zeulewan/geodude-control/README.md

# GEO-DUDe Control

Hardware photo:

GEO-DUDe hardware photo

GUI demo:

GEO-DUDe GUI demo
