zeulewan/geodude-control/firmware/README.md

# Firmware

- `nucleo/`: STM32 Nucleo / SimpleFOC firmware
- `esp32/`: ESP32 gimbal firmware

Keep motor-control debug firmware documented here or in `CLAUDE.md` before flashing hardware.
