zeulewan/geodude-control/site/docs/project/index.md

# Project

Build status and procurement tracking.

<div class="grid cards" markdown>

-   :material-format-list-bulleted:{ .lg .middle } **Bill of Materials**

    ---

    Combined BOM for both systems with links to every component

    [:octicons-arrow-right-24: BOM](bom.md)

-   :material-truck-delivery:{ .lg .middle } **Procurement**

    ---

    Order status tracking

    [:octicons-arrow-right-24: Procurement](procurement.md)

</div>

---

## Key Links

| | |
|---|---|
| **Master BOM Spreadsheet** | [Google Sheets](https://docs.google.com/spreadsheets/d/1E1N-070xhcGK5FVkjd1sBZlGc8as569FgII3UE0jsTo/edit) |
| **PDR Report** | [Google Docs](https://docs.google.com/document/d/1te-EMC-su-nKf4tSHoRYxlYj9CKJehac/edit) |
| **Task 1 Requirements** | [Google Docs](https://docs.google.com/document/d/133SueeWXB8xnZ3yEcHK812wfZaEP6CewT1eUr0M1OwU/edit) |

---

## Open Items

- [ ] Get servo datasheets and fill in power budget
- [ ] Verify buck converter current ratings
- [ ] Verify slip ring wire count is sufficient
- [ ] Size all fuses
- [ ] Assign GPIO pin mapping for Pi and ESP32
