zeulewan/geodude-control/pcb/geodude-carrier/render.png

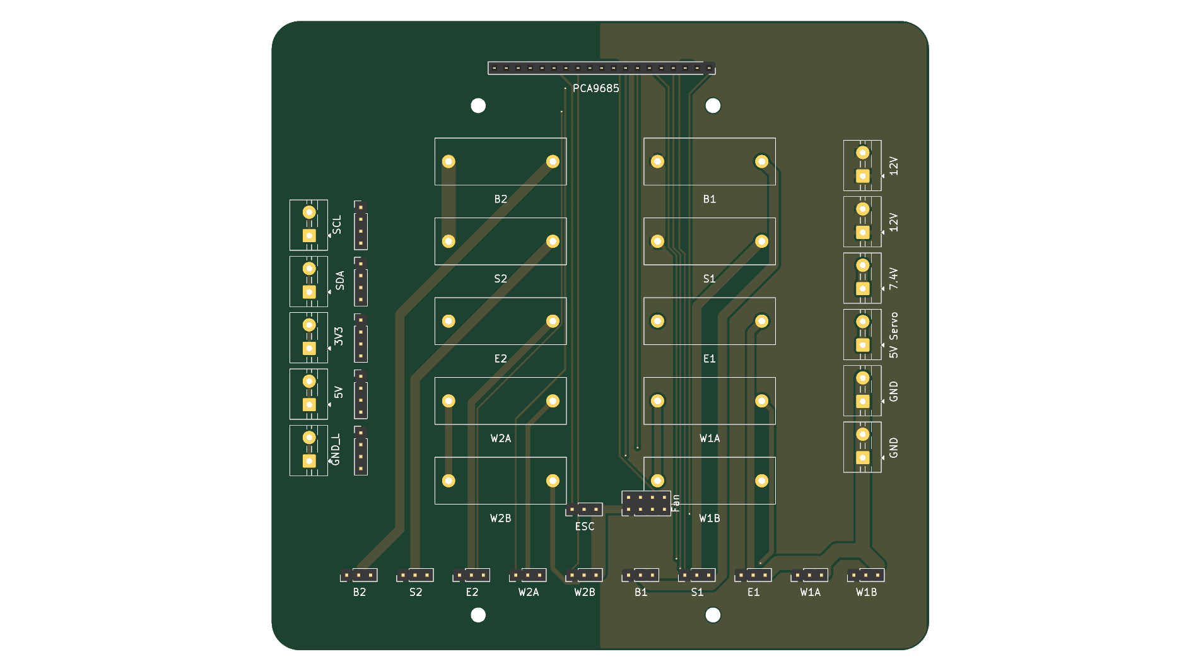
pcb/geodude-carrier/render.png
