zeulewan/geodude-control/site/docs/electrical/diagrams/L2-geodude-power-preview.png

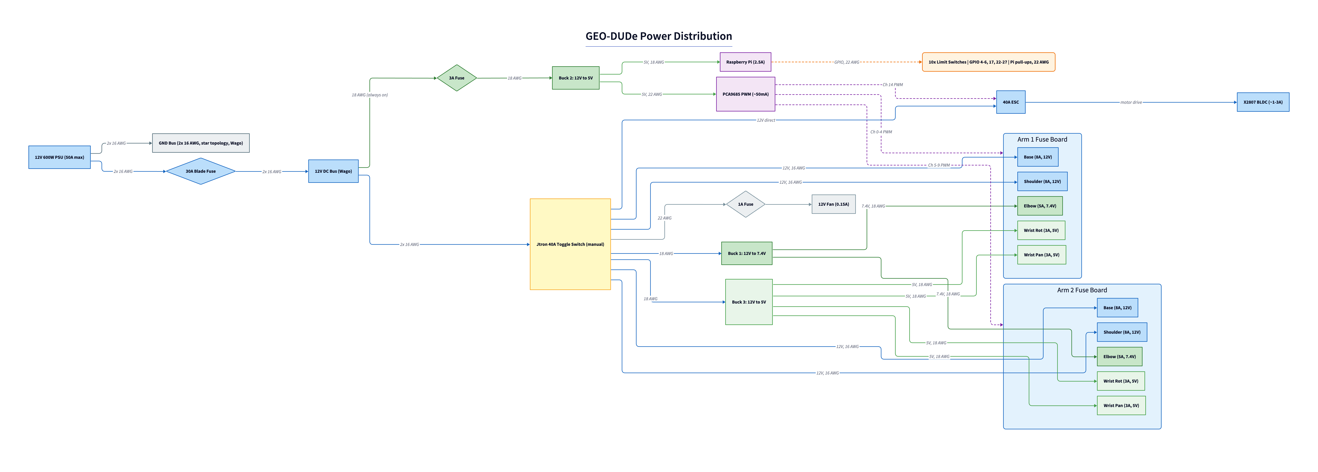
site/docs/electrical/diagrams/L2-geodude-power-preview.png
