zeulewan/geodude-control/(list of files, drawings)

Other design files:
pcb/geodude-carrier/geodude-carrier.dsn
