zeulewan/geodude-control/pcb/geodude-carrier/geodude-carrier.kicad_pcb

## KiCad design pcb/geodude-carrier/geodude-carrier.kicad_pcb (2026-03-31)

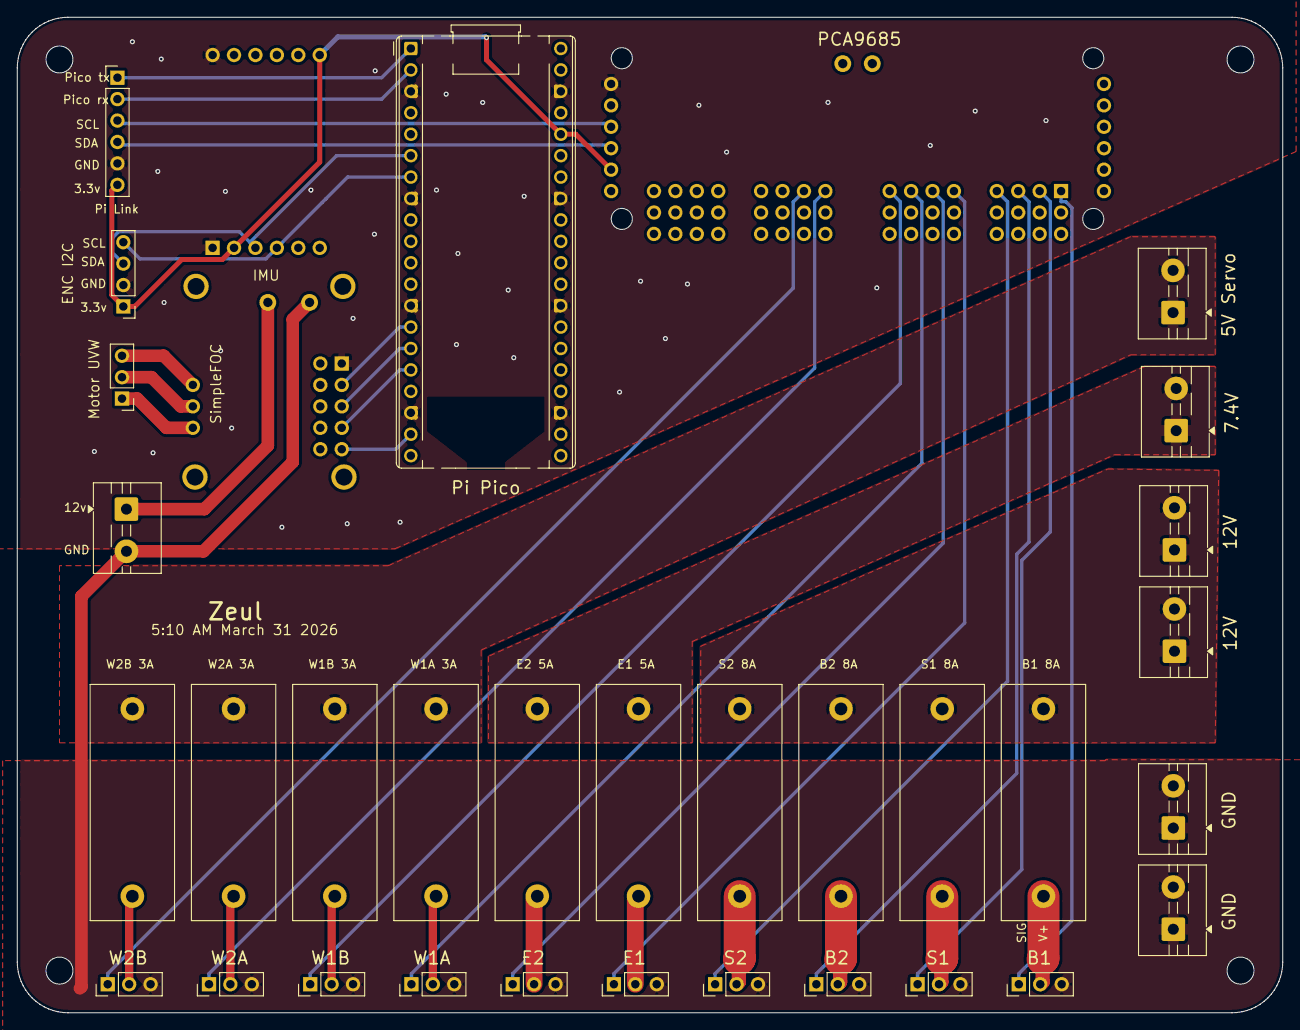
[picture p3: board geodude-carrier.kicad_pcb from above]

Board: 2 copper layers, 150.0 x 118.0 mm, 38 parts (1 on the bottom side), 40 nets.

Parts:
F1: B1 8A; BLX-A_5x20mm
F2: S1 8A; BLX-A_5x20mm
F3: E1 5A; BLX-A_5x20mm
F4: W1A 3A; BLX-A_5x20mm
F5: W1B 3A; BLX-A_5x20mm
F6: B2 8A; BLX-A_5x20mm
F7: S2 8A; BLX-A_5x20mm
F8: E2 5A; BLX-A_5x20mm
F9: W2A 3A; BLX-A_5x20mm
F10: W2B 3A; BLX-A_5x20mm
J1, J2: 12V; TerminalBlock_MaiXu_MX126-5.0-02P_1x02_P5.00mm
J3, J4: GND; TerminalBlock_MaiXu_MX126-5.0-02P_1x02_P5.00mm
J5: 7.4V; TerminalBlock_MaiXu_MX126-5.0-02P_1x02_P5.00mm
J6: 5V Servo; TerminalBlock_MaiXu_MX126-5.0-02P_1x02_P5.00mm
J_ENC: ENC I2C; PinHeader_1x04_P2.54mm_Vertical
J_FOC: SimpleFOC; SimpleFOC_Mini
J_FOC_12V: 12V FOC; TerminalBlock_MaiXu_MX126-5.0-02P_1x02_P5.00mm
J_IMU: IMU; SparkFun_ICM20948
J_MOTOR: Motor UVW; PinHeader_1x03_P2.54mm_Vertical
J_PCA: PCA9685; PCA9685_Breakout
J_PICO: Pi Pico; RaspberryPi_Pico_Common_THT
J_SERIAL: Pi Link; PinHeader_1x06_P2.54mm_Vertical
MH1, MH2, MH3, MH4: M3; MountingHole_3.2mm_M3
SV1: B1; PinHeader_1x03_P2.54mm_Vertical
SV2: S1; PinHeader_1x03_P2.54mm_Vertical
SV3: E1; PinHeader_1x03_P2.54mm_Vertical
SV4: W1A; PinHeader_1x03_P2.54mm_Vertical
SV5: W1B; PinHeader_1x03_P2.54mm_Vertical
SV6: B2; PinHeader_1x03_P2.54mm_Vertical
SV7: S2; PinHeader_1x03_P2.54mm_Vertical
SV8: E2; PinHeader_1x03_P2.54mm_Vertical
SV9: W2A; PinHeader_1x03_P2.54mm_Vertical
SV10: W2B; PinHeader_1x03_P2.54mm_Vertical

Connections:
+3V3: J_ENC.1, J_IMU.2, J_IMU.12, J_PCA.56, J_PICO.36, J_SERIAL.6
+5V_SERVO: F4.1, F5.1, F9.1, F10.1, J6.1, J6.2
+7V4: F3.1, F8.1, J5.1, J5.2
+12V: F1.1, F2.1, F6.1, F7.1, J1.1, J1.2, J2.1, J2.2
+12V_FOC: J_FOC.15, J_FOC_12V.1
FOC_EN: J_FOC.3, J_PICO.14
FOC_IN1: J_FOC.9, J_PICO.19
FOC_IN2: J_FOC.7, J_PICO.16
FOC_IN3: J_FOC.5, J_PICO.15
GND: J3.1, J3.2, J4.1, J4.2, J_FOC.14, J_FOC_12V.2, SV1.3, SV2.3, SV3.3, SV4.3, SV5.3, SV6.3, SV7.3, SV8.3, SV9.3, SV10.3
GND_LOGIC: J_ENC.2, J_FOC.1, J_IMU.1, J_IMU.7, J_PCA.60, J_PICO.3, J_PICO.8, J_PICO.13, J_PICO.18, J_PICO.23, J_PICO.28, J_PICO.33, J_PICO.38, J_SERIAL.5
MOTOR_U: J_FOC.11, J_MOTOR.3
MOTOR_V: J_FOC.12, J_MOTOR.2
MOTOR_W: J_FOC.13, J_MOTOR.1
PICO_RX: J_PICO.2, J_SERIAL.2
PICO_SCL: J_ENC.4, J_IMU.4, J_PICO.7
PICO_SDA: J_ENC.3, J_IMU.3, J_PICO.6
PICO_TX: J_PICO.1, J_SERIAL.1
PWM_CH0: J_PCA.1, SV1.1
PWM_CH1: J_PCA.4, SV2.1
PWM_CH2: J_PCA.7, SV6.1
PWM_CH3: J_PCA.10, SV7.1
PWM_CH4: J_PCA.13, SV3.1
PWM_CH5: J_PCA.16, SV8.1
PWM_CH6: J_PCA.19, SV4.1
PWM_CH7: J_PCA.22, SV5.1
PWM_CH8: J_PCA.25, SV9.1
PWM_CH9: J_PCA.28, SV10.1
SCL: J_PCA.58, J_SERIAL.3
SDA: J_PCA.57, J_SERIAL.4
SV1_PWR: F1.2, SV1.2
SV2_PWR: F2.2, SV2.2
SV3_PWR: F3.2, SV3.2
SV4_PWR: F4.2, SV4.2
SV5_PWR: F5.2, SV5.2
SV6_PWR: F6.2, SV6.2
SV7_PWR: F7.2, SV7.2
SV8_PWR: F8.2, SV8.2
SV9_PWR: F9.2, SV9.2
SV10_PWR: F10.2, SV10.2
