zeulewan/geodude-control/geodude/backend/sensor_server.py

from flask import Flask, jsonify, request, Response
import smbus2
import subprocess
import threading
import time
import os
import serial
import math
import json

app = Flask(__name__)
bus = smbus2.SMBus(1)
lock = threading.Lock()

# --- SimpleFOC serial (STM32 / Nucleo over USB) ---

PICO_PORT = "/dev/ttyACM0"
PICO_BAUD = 115200
pico_serial = None
pico_lock = threading.Lock()
simplefoc_status_lock = threading.Lock()
simplefoc_status_cache = {
    "connected": False,
    "status": None,
    "error": None,
    "updated_at": 0.0,
}


def _simplefoc_cache_status(status=None, error=None):
    with simplefoc_status_lock:
        simplefoc_status_cache["connected"] = bool(pico_serial is not None and pico_serial.is_open)
        if status is not None:
            simplefoc_status_cache["status"] = dict(status)
        if error is not None:
            simplefoc_status_cache["error"] = str(error)
        elif status is not None:
            simplefoc_status_cache["error"] = None
        simplefoc_status_cache["updated_at"] = time.monotonic()


def _simplefoc_status_snapshot():
    with simplefoc_status_lock:
        snap = dict(simplefoc_status_cache)
    status = snap.get("status") or {}
    return {
        "connected": bool(snap.get("connected")),
        "target": status.get("target", status.get("run_target")),
        "wheel_rpm": status.get("enc_rpm"),
        "wheel_angle_deg": status.get("enc_deg"),
        "foc_ready": status.get("foc_ready"),
        "armed": status.get("armed"),
        "raw_status": status if status else None,
        "serial_error": snap.get("error"),
        "updated_at": snap.get("updated_at", 0.0),
    }

def get_pico():
    """Return open serial port to the STM32 / Nucleo controller, opening it lazily if needed."""
    global pico_serial
    with pico_lock:
        if pico_serial is None or not pico_serial.is_open:
            try:
                pico_serial = serial.Serial(PICO_PORT, PICO_BAUD, timeout=0.5)
                _simplefoc_cache_status(status=None, error=None)
                # Firmware state unknown across a re-open: force re-push of
                # mode/voltage/ramp on next jog.
                simplefoc_pushed["mode"] = None
                simplefoc_pushed["voltage"] = None
                simplefoc_pushed["ramp"] = None
            except Exception as e:
                print("SimpleFOC serial open error: %s" % e, flush=True)
                pico_serial = None
                _simplefoc_cache_status(status=None, error=e)
        return pico_serial


def _simplefoc_fire_and_forget_locked(ser, cmd):
    """Write a command and return immediately, without draining replies.
    Used on the jog hot path (T, E, D) where firmware produces no output
    while armed and where we accept losing an ERR reply in exchange for
    latency. Any status line the firmware emits will be picked up by the
    next actual read (status poll, calibrate, etc.). Caller MUST hold
    pico_lock."""
    cmd = str(cmd).strip()
    if not cmd:
        return
    ser.write((cmd + "\n").encode())
    ser.flush()


def _simplefoc_exchange_locked(ser, cmd, read_for=0.2):
    cmd = str(cmd).strip()
    if not cmd:
        return [], None, None
    try:
        ser.reset_input_buffer()
    except Exception:
        pass
    ser.write((cmd + "\n").encode())
    ser.flush()
    lines = []
    last_status = None
    err = None
    end = time.time() + read_for
    while time.time() < end:
        line = ser.readline().decode(errors="ignore").strip()
        if not line:
            continue
        lines.append(line)
        if line.startswith("ERR"):
            err = line
            break
        if line.startswith("{") and line.endswith("}"):
            try:
                last_status = json.loads(line)
                _simplefoc_cache_status(status=last_status, error=None)
            except Exception as exc:
                err = "status parse error: %s" % exc
                _simplefoc_cache_status(error=err)
                break
    return lines, last_status, err


def _simplefoc_status_locked(ser, timeout=0.25):
    _lines, status, err = _simplefoc_exchange_locked(ser, "S", read_for=timeout)
    if err:
        raise RuntimeError(err)
    return status


def simplefoc_send(cmd, read_for=0.2):
    """Send a raw SimpleFOC Commander command and surface firmware ERR replies."""
    global pico_serial
    try:
        ser = get_pico()
        if ser is None:
            return False, "serial not available"
        with pico_lock:
            _lines, _status, err = _simplefoc_exchange_locked(ser, cmd, read_for=read_for)
        print("SimpleFOC: sent %r" % str(cmd).strip(), flush=True)
        if err:
            return False, err
        return True, None
    except Exception as e:
        with pico_lock:
            pico_serial = None
        _simplefoc_cache_status(error=e)
        print("SimpleFOC serial error: %s" % e, flush=True)
        return False, str(e)


SIMPLEFOC_JOG_MAX_RPM = 500.0
SIMPLEFOC_JOG_MAX_RAD_S = SIMPLEFOC_JOG_MAX_RPM * 2.0 * math.pi / 60.0
SIMPLEFOC_JOG_MIN_VOLTAGE = 0.5
SIMPLEFOC_JOG_MAX_VOLTAGE = 24.0
SIMPLEFOC_JOG_MIN_RAMP = 0.1
SIMPLEFOC_JOG_MAX_RAMP = 2000.0  # matches firmware R cap; ~30ms to target
SIMPLEFOC_JOG_TIMEOUT_S = 0.5

simplefoc_jog_lock = threading.Lock()
simplefoc_jog_state = {
    "active": None,  # forward/backward/brake
    "status": "idle",
    "error": None,
    "simplefoc_target": 0.0,
    "max_voltage": 12.0,
    "accel_ramp": 5.0,
    "brake_ramp": 12.0,
    "last_heartbeat": 0.0,
    "last_command_at": 0.0,
}

# Pre-empt counter: any /jog/stop bumps cmd_counter and stamps last_stop_seq.
# /jog/start captures its own seq; if last_stop_seq > my_seq before we emit
# T+E, we abort. Ensures a release that arrives mid-start cannot be overtaken
# by the start's final motor-enable.
simplefoc_cmd_counter = 0
simplefoc_last_stop_seq = 0

# Cached firmware config. Only push MR/V/R over serial when the request
# differs from what the firmware already has. Turns the hot path from a
# 6-command burst into 1-2 commands on repeat presses.
# Cleared on disconnect / boot so first press after reboot still pushes.
simplefoc_pushed = {"mode": None, "voltage": None, "ramp": None}


def _simplefoc_jog_clamp_voltage(value):
    return max(SIMPLEFOC_JOG_MIN_VOLTAGE, min(float(value), SIMPLEFOC_JOG_MAX_VOLTAGE))


def _simplefoc_jog_clamp_ramp(value):
    return max(SIMPLEFOC_JOG_MIN_RAMP, min(float(value), SIMPLEFOC_JOG_MAX_RAMP))


def _simplefoc_jog_snapshot():
    with simplefoc_jog_lock:
        snap = dict(simplefoc_jog_state)
    snap.update(_simplefoc_status_snapshot())
    snap["target"] = snap.get("simplefoc_target")
    return snap


def _rw_log(event, **fields):
    """Structured jog-path log. Grep with: journalctl -u sensor-server -f | grep '\\[rw\\]'
    Fields are key=value, space-separated, sorted by key for stable output."""
    parts = [f"{k}={fields[k]}" for k in sorted(fields)]
    print(f"[rw] {event} " + " ".join(parts), flush=True)


def _simplefoc_jog_disable(status="idle", error=None):
    """Coast via firmware `D` (disable drivers). This is the release/watchdog
    failsafe: coast, never active brake."""
    global simplefoc_last_stop_seq, simplefoc_cmd_counter, pico_serial
    t0 = time.monotonic()
    with simplefoc_jog_lock:
        simplefoc_cmd_counter += 1
        simplefoc_last_stop_seq = simplefoc_cmd_counter
        prev_active = simplefoc_jog_state["active"]
    # Fire-and-forget D. Release must be snappy; firmware emits nothing we
    # need to read synchronously.
    try:
        ser = get_pico()
        if ser is not None:
            with pico_lock:
                _simplefoc_fire_and_forget_locked(ser, "D")
    except Exception as e:
        with pico_lock:
            pico_serial = None
        _simplefoc_cache_status(error=e)
    with simplefoc_jog_lock:
        simplefoc_jog_state["active"] = None
        simplefoc_jog_state["status"] = status
        simplefoc_jog_state["error"] = error
        simplefoc_jog_state["simplefoc_target"] = 0.0
        simplefoc_jog_state["last_command_at"] = time.monotonic()
    _rw_log("coast", reason=status, prev=prev_active, err=error,
            stop_seq=simplefoc_last_stop_seq, elapsed_ms=round((time.monotonic()-t0)*1000, 1))


def _simplefoc_jog_start(direction, max_voltage, accel_ramp, brake_ramp):
    global simplefoc_cmd_counter
    t0 = time.monotonic()
    target = 0.0
    if direction == "forward":
        target = SIMPLEFOC_JOG_MAX_RAD_S
    elif direction == "backward":
        target = -SIMPLEFOC_JOG_MAX_RAD_S
    elif direction == "brake":
        target = 0.0
    else:
        raise ValueError("direction must be forward/backward/brake")
    ramp = brake_ramp if direction == "brake" else accel_ramp
    max_voltage = _simplefoc_jog_clamp_voltage(max_voltage)
    accel_ramp = _simplefoc_jog_clamp_ramp(accel_ramp)
    brake_ramp = _simplefoc_jog_clamp_ramp(brake_ramp)

    # Use cached foc_ready instead of a pre-flight serial round-trip. If the
    # cache is stale the firmware will reject `E` with ERR anyway.
    cached = _simplefoc_status_snapshot()
    if not cached.get("foc_ready"):
        raise RuntimeError("wheel not calibrated; run calibration first")

    with simplefoc_jog_lock:
        simplefoc_cmd_counter += 1
        my_seq = simplefoc_cmd_counter

    ser = get_pico()
    if ser is None:
        raise RuntimeError("serial not available")

    with pico_lock:
        # Lazy config push. Only send MR/V/R when the firmware doesn't already
        # have these values.
        pending = []
        if simplefoc_pushed["mode"] != "rate":
            pending.append(("MR", 0.03))
        vstr = f"{max_voltage:.3f}"
        if simplefoc_pushed["voltage"] != vstr:
            pending.append((f"V{vstr}", 0.03))
        rstr = f"{ramp:.3f}"
        if simplefoc_pushed["ramp"] != rstr:
            pending.append((f"R{rstr}", 0.03))

        for cmd, _delay in pending:
            _simplefoc_fire_and_forget_locked(ser, cmd)
        if pending:
            simplefoc_pushed["mode"] = "rate"
            simplefoc_pushed["voltage"] = vstr
            simplefoc_pushed["ramp"] = rstr

        # Pre-empt check: if a /jog/stop arrived after we took my_seq, abort.
        # The release has already (or will) coast via D; don't re-arm.
        with simplefoc_jog_lock:
            preempted = simplefoc_last_stop_seq > my_seq
        if preempted:
            # Belt-and-suspenders: ensure coast even if the release's D
            # somehow landed before our lock acquire.
            _simplefoc_exchange_locked(ser, "D", read_for=0.02)
            _rw_log("preempt", phase="pre_TE", direction=direction, my_seq=my_seq,
                    stop_seq=simplefoc_last_stop_seq,
                    elapsed_ms=round((time.monotonic()-t0)*1000, 1))
            raise RuntimeError("preempted by release")

        # Hot path: T then E. Fire-and-forget — firmware produces no reply
        # while armed, and we want pico_lock held for milliseconds not tens
        # of ms. If the firmware rejects (unlikely since we checked
        # foc_ready), the next status poll will show armed=false and the
        # user can retry. Watchdog still owns the safety net.
        _simplefoc_fire_and_forget_locked(ser, f"T{target:.5f}")
        _simplefoc_fire_and_forget_locked(ser, "E")

    with simplefoc_jog_lock:
        # Only claim active if no newer stop arrived during T+E.
        if simplefoc_last_stop_seq > my_seq:
            # A release snuck in; disable after unlocking.
            needs_coast = True
        else:
            needs_coast = False
            simplefoc_jog_state["active"] = direction
            simplefoc_jog_state["status"] = "running"
            simplefoc_jog_state["error"] = None
            simplefoc_jog_state["simplefoc_target"] = target
            simplefoc_jog_state["max_voltage"] = max_voltage
            simplefoc_jog_state["accel_ramp"] = accel_ramp
            simplefoc_jog_state["brake_ramp"] = brake_ramp
            simplefoc_jog_state["last_heartbeat"] = time.monotonic()
            simplefoc_jog_state["last_command_at"] = time.monotonic()
    if needs_coast:
        simplefoc_send("D")
        _rw_log("preempt", phase="post_TE", direction=direction, my_seq=my_seq,
                stop_seq=simplefoc_last_stop_seq,
                elapsed_ms=round((time.monotonic()-t0)*1000, 1))
        raise RuntimeError("preempted by release")
    _rw_log("hold_start", direction=direction, target=round(target, 3),
            v=max_voltage, ramp=round(ramp, 3),
            pushed=len(pending),
            my_seq=my_seq,
            elapsed_ms=round((time.monotonic()-t0)*1000, 1))


def simplefoc_status_poll_loop():
    """Refresh the status cache from the firmware so wheel_rpm stays live
    while the motor is spinning. Firmware only prints on events, so without
    this the UI reads a frozen value between press and release.

    Cadence is 500ms while active (3.4% of firmware time blocked on
    Serial.print — acceptable; tighten if needed) and 2s while idle (so
    /simplefoc/jog/status still shows a recent foc_ready etc.). Uses
    pico_lock with a short read_for so it loses the race to any user
    command cleanly."""
    while True:
        with simplefoc_jog_lock:
            active = simplefoc_jog_state["active"]
        period = 0.5 if active else 2.0
        try:
            ser = get_pico()
            if ser is not None:
                with pico_lock:
                    _simplefoc_status_locked(ser, timeout=0.05)
        except Exception as exc:
            _simplefoc_cache_status(error=exc)
        time.sleep(period)


def simplefoc_jog_watchdog_loop():
    while True:
        time.sleep(0.05)
        with simplefoc_jog_lock:
            active = simplefoc_jog_state["active"]
            last_heartbeat = simplefoc_jog_state["last_heartbeat"]
        if not active:
            continue
        stale_ms = round((time.monotonic() - last_heartbeat) * 1000, 0)
        if stale_ms <= SIMPLEFOC_JOG_TIMEOUT_S * 1000:
            continue
        _rw_log("watchdog_trip", active=active, stale_ms=stale_ms)
        try:
            _simplefoc_jog_disable(status="watchdog stop", error=None)
        except Exception as exc:
            with simplefoc_jog_lock:
                simplefoc_jog_state["active"] = None
                simplefoc_jog_state["status"] = "watchdog error"
                simplefoc_jog_state["error"] = str(exc)
                simplefoc_jog_state["last_command_at"] = time.monotonic()
            _rw_log("watchdog_err", err=str(exc))

sensor_data = {
    "ax": 0, "ay": 0, "az": 0,
    "gx": 0, "gy": 0, "gz": 0,
    "angle": 0, "rpm": 0,
    "analog_va": 0, "analog_vb": 0,
    "analog_electrical_deg": 0, "analog_mechanical_deg": 0,
    "i2c_ok": False, "ads_ok": False, "imu_ok": False,
}

# --- PCA9685 PWM driver ---

PCA9685_ADDR = 0x40
MODE1 = 0x00
PRESCALE = 0xFE
LED0_ON_L = 0x06

# Channel mapping (pin - 1 = 0-indexed)
# MACE reaction wheel is no longer on PCA9685 — it is driven by the STM32 / Nucleo SimpleFOC controller
CHANNELS = {
    "B1":   0,
    "S1":   1,
    "B2":   2,
    "S2":   3,
    "E1":   4,
    "E2":   5,
    "W1A":  6,
    "W1B":  7,
    "W2A":  8,
    "W2B":  9,
}

# --- Servo safety state ---
# Max change in pulse-width allowed per single /pwm request.
# Prevents servo jumps if the client-side ramp loses packets. Tune carefully:
#   - Too small: legitimate moves get clamped and feel laggy.
#   - Too large: big jumps can slip past.
# With client ramp at 30 Hz and max 10 us/tick, normal delta is <= 10 us.
# 50 us is a safe cap: legitimate ramp fits, jumps from lost commands get clipped.
SERVO_MAX_DELTA_US = 50

_servo_last_pw = {name: None for name in CHANNELS}  # last successfully written
_servo_last_seq = {name: -1 for name in CHANNELS}   # highest seq accepted
_servo_locks = {name: threading.Lock() for name in CHANNELS}
_servo_health_lock = threading.Lock()  # H-D/M-E: covers PCA counters + snapshot reads


def pca_init(freq=50):
    # Sleep to change prescale
    bus.write_byte_data(PCA9685_ADDR, MODE1, 0x10)  # SLEEP
    prescale = round(25_000_000 / (4096 * freq)) - 1
    bus.write_byte_data(PCA9685_ADDR, PRESCALE, prescale)
    # Wake: clear SLEEP, enable auto-increment + RESTART
    bus.write_byte_data(PCA9685_ADDR, MODE1, 0x00)  # wake
    time.sleep(0.005)
    bus.write_byte_data(PCA9685_ADDR, MODE1, 0xA0)  # RESTART + AI

_pca_write_errors = 0         # H-D: protected by _servo_health_lock
_pca_readback_mismatches = 0

def _pca_bump(counter_name):
    """H-D: atomic counter increment. CPython += on int is NOT atomic."""
    global _pca_write_errors, _pca_readback_mismatches
    with _servo_health_lock:
        if counter_name == "write":
            _pca_write_errors += 1
        else:
            _pca_readback_mismatches += 1


def pca_set_pulse_us(channel, pulse_us, freq=50):
    """Write + verify. Returns True on verified write, False on failure."""
    period_us = 1_000_000 / freq
    counts = int(pulse_us / period_us * 4096)
    counts = max(0, min(4095, counts))
    reg = LED0_ON_L + 4 * channel
    payload = [0, 0, counts & 0xFF, (counts >> 8) & 0xFF]
    for attempt in range(2):
        try:
            with lock:
                # H-E: reassert MODE1 = RESTART+AI so multi-byte readback
                # auto-increments. If the chip browned out and lost this bit,
                # readback would return the same register byte 4x and a
                # pw=0 write would falsely pass verification.
                bus.write_byte_data(PCA9685_ADDR, MODE1, 0xA0)
                bus.write_i2c_block_data(PCA9685_ADDR, reg, payload)
                got = bus.read_i2c_block_data(PCA9685_ADDR, reg, 4)
            if list(got) == payload:
                return True
            _pca_bump("mismatch")
        except Exception:
            _pca_bump("write")
    return False

def pca_off(channel):
    reg = LED0_ON_L + 4 * channel
    with lock:
        bus.write_i2c_block_data(PCA9685_ADDR, reg, [0, 0, 0, 0])

def pca_all_off():
    with lock:
        for ch in range(16):
            reg = LED0_ON_L + 4 * ch
            bus.write_i2c_block_data(PCA9685_ADDR, reg, [0, 0, 0, 0])

def _servo_seed_last_pw_from_pca(freq=50):
    """L-E: on boot, seed _servo_last_pw from whatever the PCA9685 is actually
    outputting right now. This closes the "first write bypasses clamp" hole
    where _servo_last_pw[name] was None so the 50us delta clamp was skipped.

    Must be called after pca_init so MODE1 auto-increment is on.
    """
    period_us = 1_000_000 / freq
    for name, ch in CHANNELS.items():
        reg = LED0_ON_L + 4 * ch
        try:
            with lock:
                got = bus.read_i2c_block_data(PCA9685_ADDR, reg, 4)
            counts = ((got[3] & 0x0F) << 8) | got[2]
            pw = int(round(counts * period_us / 4096))
            _servo_last_pw[name] = pw if 0 <= pw <= 2500 else 0
        except Exception:
            # Leave as None; first write will have no clamp — but log.
            print(f"[servo] seed_last_pw failed for {name}", flush=True)


# --- Sensor reading ---

ADS1115_ADDR = 0x48
MAGNET_COUNT = 32
ANALOG_POLE_PAIRS = MAGNET_COUNT // 2
SENSOR_SUPPLY_V = 3.3
OFFSET_A_V = SENSOR_SUPPLY_V * 0.5
OFFSET_B_V = SENSOR_SUPPLY_V * 0.5
AMP_ALPHA = 0.01
MIN_SIGNAL_V = 0.02
ANGLE_HOLD_THRESHOLD_V = 0.01


def _i16(msb, lsb):
    value = (msb << 8) | lsb
    return value - 0x10000 if value & 0x8000 else value


def _wrap_delta_deg(delta):
    while delta > 180.0:
        delta -= 360.0
    while delta < -180.0:
        delta += 360.0
    return delta


class ADS1115:
    REG_CONVERSION = 0x00
    REG_CONFIG = 0x01
    OS_SINGLE = 0x8000
    MUX_SINGLE = (0x4000, 0x5000, 0x6000, 0x7000)
    PGA_4V096 = 0x0200
    MODE_SINGLE = 0x0100
    DATA_RATE_860 = 0x00E0
    COMP_DISABLE = 0x0003

    def __init__(self, bus_obj, address=ADS1115_ADDR):
        self.bus = bus_obj
        self.address = address

    def read_raw(self, channel):
        config = (
            self.OS_SINGLE
            | self.MUX_SINGLE[channel]
            | self.PGA_4V096
            | self.MODE_SINGLE
            | self.DATA_RATE_860
            | self.COMP_DISABLE
        )
        self.bus.write_i2c_block_data(self.address, self.REG_CONFIG, [(config >> 8) & 0xFF, config & 0xFF])
        time.sleep(0.002)
        msb, lsb = self.bus.read_i2c_block_data(self.address, self.REG_CONVERSION, 2)
        return _i16(msb, lsb)

    def read_voltage(self, channel):
        return self.read_raw(channel) * (4.096 / 32768.0)


def r16(addr, reg):
    h = bus.read_byte_data(addr, reg)
    l = bus.read_byte_data(addr, reg + 1)
    v = (h << 8) | l
    return v - 65536 if v > 32767 else v

def sensor_loop():
    ads = ADS1115(bus, ADS1115_ADDR)
    imu_ready = False
    imu_warned = False
    last_imu_error = None
    offset_a = OFFSET_A_V
    offset_b = OFFSET_B_V
    amp_a = 1.0
    amp_b = 1.0
    prev_electrical_deg = None
    continuous_electrical_deg = 0.0
    last_mechanical_deg = None
    last_time = None
    rpm_buf = []
    while True:
        try:
            if not imu_ready:
                try:
                    with lock:
                        bus.write_byte_data(0x69, 0x06, 0x01)
                    time.sleep(0.05)
                    imu_ready = True
                    imu_warned = False
                    last_imu_error = None
                except Exception as e:
                    imu_ready = False
                    last_imu_error = e
                    if not imu_warned:
                        print("sensor_loop IMU unavailable; continuing without IMU: %s" % e, flush=True)
                        imu_warned = True
            with lock:
                va = ads.read_voltage(0)
                vb = ads.read_voltage(1)
            ax = ay = az = gx = gy = gz = 0.0
            imu_ok = False
            if imu_ready:
                try:
                    with lock:
                        ax = r16(0x69, 0x2D) / 16384.0
                        ay = r16(0x69, 0x2F) / 16384.0
                        az = r16(0x69, 0x31) / 16384.0
                        gx = r16(0x69, 0x33) / 131.0
                        gy = r16(0x69, 0x35) / 131.0
                        gz = r16(0x69, 0x37) / 131.0
                    imu_ok = True
                except Exception as e:
                    imu_ready = False
                    last_imu_error = e
                    print("sensor_loop IMU read failed; retrying init: %s" % e, flush=True)
            centered_a = va - offset_a
            centered_b = vb - offset_b
            amp_a = max(MIN_SIGNAL_V, (1.0 - AMP_ALPHA) * amp_a + AMP_ALPHA * abs(centered_a))
            amp_b = max(MIN_SIGNAL_V, (1.0 - AMP_ALPHA) * amp_b + AMP_ALPHA * abs(centered_b))
            norm_a = centered_a / amp_a
            norm_b = centered_b / amp_b

            electrical_deg = math.degrees(math.atan2(norm_b, norm_a))
            if electrical_deg < 0.0:
                electrical_deg += 360.0

            magnitude_v = math.sqrt(centered_a * centered_a + centered_b * centered_b)
            if magnitude_v >= ANGLE_HOLD_THRESHOLD_V:
                if prev_electrical_deg is None:
                    continuous_electrical_deg = electrical_deg
                else:
                    continuous_electrical_deg += _wrap_delta_deg(electrical_deg - prev_electrical_deg)
                prev_electrical_deg = electrical_deg
            elif prev_electrical_deg is None:
                prev_electrical_deg = electrical_deg

            continuous_mechanical_deg = continuous_electrical_deg / ANALOG_POLE_PAIRS
            angle = continuous_mechanical_deg % 360.0
            # Compute RPM from encoder at 100Hz
            now = time.monotonic()
            rpm = 0.0
            if last_mechanical_deg is not None and last_time is not None:
                dt = now - last_time
                if dt > 0:
                    delta = continuous_mechanical_deg - last_mechanical_deg
                    dps = delta / dt
                    rpm_buf.append(dps / 6.0)  # signed RPM
                    if len(rpm_buf) > 10:
                        rpm_buf.pop(0)
                    rpm = sum(rpm_buf) / len(rpm_buf)
            last_mechanical_deg = continuous_mechanical_deg
            last_time = now
            sensor_data.update({
                "ax": round(ax, 3), "ay": round(ay, 3), "az": round(az, 3),
                "gx": round(gx, 1), "gy": round(gy, 1), "gz": round(gz, 1),
                "angle": round(angle, 1),
                "rpm": round(rpm, 1),
                "analog_va": round(va, 5),
                "analog_vb": round(vb, 5),
                "analog_electrical_deg": round(electrical_deg, 2),
                "analog_mechanical_deg": round(angle, 2),
                "i2c_ok": True,
                "ads_ok": True,
                "imu_ok": imu_ok,
            })
        except Exception as e:
            print("sensor_loop error: %s" % e, flush=True)
            sensor_data.update({
                "i2c_ok": False,
                "ads_ok": False,
                "imu_ok": imu_ready and last_imu_error is None,
            })
        time.sleep(0.033)

# --- API ---

@app.route("/sensors")
def sensors():
    if os.path.exists("/tmp/motor_heartbeat"):
        os.utime("/tmp/motor_heartbeat", None)
    else:
        open("/tmp/motor_heartbeat","w").close()
    with lock:
        return jsonify(sensor_data)

@app.route("/system")
def system_stats():
    """CPU usage and temperature."""
    try:
        with open("/sys/class/thermal/thermal_zone0/temp") as f:
            temp = int(f.read().strip()) / 1000.0
    except Exception:
        temp = 0
    try:
        with open("/proc/loadavg") as f:
            load = float(f.read().split()[0])
    except Exception:
        load = 0
    try:
        with open("/proc/stat") as f:
            line = f.readline()
            parts = line.split()
            idle = int(parts[4])
            total = sum(int(x) for x in parts[1:])
        if not hasattr(system_stats, "_prev"):
            system_stats._prev = (total, idle)
        prev_total, prev_idle = system_stats._prev
        dt = total - prev_total
        di = idle - prev_idle
        cpu_pct = round((1.0 - di / dt) * 100, 1) if dt > 0 else 0
        system_stats._prev = (total, idle)
    except Exception:
        cpu_pct = 0
    return jsonify({"temp": round(temp, 1), "cpu": cpu_pct, "load": round(load, 2)})

@app.route("/simplefoc", methods=["POST"])
def simplefoc():
    """Send a velocity command to the wheel controller (SimpleFOC Commander protocol).
    Body: {"velocity": 5.0}  — sets target velocity in rad/s
       or {"command": "T5"} — sends a raw commander command
    """
    if os.path.exists("/tmp/attitude_active"):
        return jsonify({"ok": False, "error": "attitude controller active"}), 409
    data = request.json
    if "command" in data:
        cmd = str(data["command"])
    elif "velocity" in data:
        v = float(data["velocity"])
        cmd = "T%.4f" % v
    else:
        return jsonify({"ok": False, "error": "missing velocity or command"}), 400
    ok, err = simplefoc_send(cmd)
    if ok:
        return jsonify({"ok": True, "cmd": cmd})
    return jsonify({"ok": False, "error": err}), 502

@app.route("/simplefoc/status")
def simplefoc_status():
    """Query STM32 connection/target without fighting active serial traffic."""
    ser = get_pico()
    connected = ser is not None and ser.is_open
    cached = _simplefoc_status_snapshot()
    if simplefoc_jog_state.get("active"):
        return jsonify({
            "connected": connected,
            "target": simplefoc_jog_state.get("simplefoc_target"),
            "live": False,
            "jog": True,
            "foc_ready": cached.get("foc_ready"),
        })
    target = None
    if simplefoc_live_state.get("enabled") or simplefoc_live_state.get("sweep_busy"):
        return jsonify({
            "connected": connected,
            "target": simplefoc_live_state.get("rate_target_rpm"),
            "live": True,
        })
    if connected:
        try:
            with pico_lock:
                status = _simplefoc_status_locked(ser, timeout=0.25)
            if status:
                target = status.get("target", status.get("run_target"))
        except Exception as e:
            print("SimpleFOC status read error: %s" % e, flush=True)
            _simplefoc_cache_status(error=e)
    return jsonify({
        "connected": connected,
        "target": target,
        "foc_ready": cached.get("foc_ready"),
        "armed": cached.get("armed"),
        "serial_error": cached.get("serial_error"),
    })


@app.route("/simplefoc/jog/status")
def simplefoc_jog_status():
    return jsonify(_simplefoc_jog_snapshot())


@app.route("/simplefoc/jog/start", methods=["POST"])
def simplefoc_jog_start_route():
    with simplefoc_calibrate_lock:
        if simplefoc_calibrate_state["busy"]:
            return jsonify({"ok": False, "error": "calibrating"}), 409
    with simplefoc_profile_lock:
        if simplefoc_profile_state["busy"] or simplefoc_torque_state["busy"]:
            return jsonify({"ok": False, "error": "profile/torque busy"}), 409
    with simplefoc_live_lock:
        if simplefoc_live_state.get("enabled") or simplefoc_live_state.get("sweep_busy"):
            return jsonify({"ok": False, "error": "live control busy"}), 409
    data = request.json or {}
    direction = str(data.get("direction", "")).lower()
    if direction not in ("forward", "backward", "brake"):
        return jsonify({"ok": False, "error": "direction must be forward/backward/brake"}), 400
    max_voltage = _simplefoc_jog_clamp_voltage(data.get("max_voltage", 12.0))
    accel_ramp = _simplefoc_jog_clamp_ramp(data.get("accel_ramp", 5.0))
    brake_ramp = _simplefoc_jog_clamp_ramp(data.get("brake_ramp", 12.0))
    try:
        _simplefoc_jog_start(direction, max_voltage, accel_ramp, brake_ramp)
    except Exception as exc:
        with simplefoc_jog_lock:
            simplefoc_jog_state["status"] = "error"
            simplefoc_jog_state["error"] = str(exc)
            simplefoc_jog_state["last_command_at"] = time.monotonic()
        return jsonify({"ok": False, "error": str(exc)}), 502
    return jsonify({"ok": True, **_simplefoc_jog_snapshot()})


simplefoc_calibrate_lock = threading.Lock()
simplefoc_calibrate_state = {
    "busy": False,
    "status": "idle",
    "error": None,
}


def _simplefoc_calibrate_worker():
    """Send G to the firmware and wait for initFOC_ok / initFOC_failed.

    Decoupled from the tuning/profile subsystem so calibration and jog state
    don't cross-contaminate. Total wall time up to ~10s on a slow calibration.
    """
    t0 = time.monotonic()
    _rw_log("calibrate_start")
    ser = get_pico()
    if ser is None:
        with simplefoc_calibrate_lock:
            simplefoc_calibrate_state["busy"] = False
            simplefoc_calibrate_state["status"] = "error"
            simplefoc_calibrate_state["error"] = "serial not available"
        return
    try:
        with pico_lock:
            try:
                ser.reset_input_buffer()
            except Exception:
                pass
            ser.write(b"G\n")
            ser.flush()
            status = "running"
            err = None
            deadline = time.time() + 10.0
            while time.time() < deadline:
                line = ser.readline().decode(errors="ignore").strip()
                if not line:
                    continue
                if line.startswith("ERR"):
                    err = line
                    status = "error"
                    break
                if line.startswith("{") and line.endswith("}"):
                    try:
                        data = json.loads(line)
                        _simplefoc_cache_status(status=data, error=None)
                        event = data.get("event", "")
                        if event == "initFOC_ok" or data.get("foc_ready"):
                            status = "ready"
                            break
                        if event == "initFOC_failed":
                            status = "failed"
                            err = "initFOC_failed"
                            break
                    except Exception:
                        pass
        with simplefoc_calibrate_lock:
            simplefoc_calibrate_state["busy"] = False
            simplefoc_calibrate_state["status"] = status
            simplefoc_calibrate_state["error"] = err
        _rw_log("calibrate_done", status=status, err=err,
                elapsed_ms=round((time.monotonic()-t0)*1000, 0))
    except Exception as exc:
        with simplefoc_calibrate_lock:
            simplefoc_calibrate_state["busy"] = False
            simplefoc_calibrate_state["status"] = "error"
            simplefoc_calibrate_state["error"] = str(exc)
        _rw_log("calibrate_done", status="error", err=str(exc),
                elapsed_ms=round((time.monotonic()-t0)*1000, 0))


@app.route("/simplefoc/calibrate", methods=["POST"])
def simplefoc_calibrate_route():
    with simplefoc_calibrate_lock:
        if simplefoc_calibrate_state["busy"]:
            return jsonify({"ok": False, "error": "calibrating"}), 409
        simplefoc_calibrate_state["busy"] = True
        simplefoc_calibrate_state["status"] = "running"
        simplefoc_calibrate_state["error"] = None
    # A calibration invalidates cached pushed config (firmware disables motor
    # and resets limits inside run_calibration()).
    simplefoc_pushed["mode"] = None
    simplefoc_pushed["voltage"] = None
    simplefoc_pushed["ramp"] = None
    threading.Thread(target=_simplefoc_calibrate_worker, daemon=True).start()
    return jsonify({"ok": True})


@app.route("/simplefoc/calibrate/state")
def simplefoc_calibrate_state_route():
    with simplefoc_calibrate_lock:
        return jsonify(dict(simplefoc_calibrate_state))


@app.route("/simplefoc/jog/heartbeat", methods=["POST"])
def simplefoc_jog_heartbeat_route():
    """Heartbeat MUST NOT touch the serial port. It runs at 10Hz; a serial
    round-trip here starves the stop path of pico_lock. Fresh telemetry is
    the status poll's job."""
    data = request.json or {}
    direction = str(data.get("direction", "")).lower()
    with simplefoc_jog_lock:
        active = simplefoc_jog_state["active"]
        if direction and active and direction != active:
            return jsonify({"ok": False, "error": "active direction mismatch"}), 409
        if not active:
            return jsonify({"ok": False, "error": "no active hold"}), 409
        simplefoc_jog_state["last_heartbeat"] = time.monotonic()
    return jsonify({"ok": True, **_simplefoc_jog_snapshot()})


@app.route("/simplefoc/jog/stop", methods=["POST"])
def simplefoc_jog_stop_route():
    try:
        _simplefoc_jog_disable()
        error = None
    except Exception as exc:
        error = str(exc)
    with simplefoc_jog_lock:
        simplefoc_jog_state["last_command_at"] = time.monotonic()
    if error is not None:
        with simplefoc_jog_lock:
            simplefoc_jog_state["status"] = "error"
            simplefoc_jog_state["error"] = error
        return jsonify({"ok": False, "error": error}), 502
    return jsonify({"ok": True, **_simplefoc_jog_snapshot()})


# --- SimpleFOC autonomous profile tuning/logging ---

simplefoc_profile_lock = threading.Lock()
simplefoc_profile_stop_requested = False
simplefoc_profile_state = {
    "status": "idle",
    "busy": False,
    "last_status": None,
    "last_log": [],
    "raw": [],
    "error": None,
}


def _profile_add_raw(line):
    with simplefoc_profile_lock:
        simplefoc_profile_state["raw"].append(str(line))
        simplefoc_profile_state["raw"] = simplefoc_profile_state["raw"][-500:]


def _profile_set(**kwargs):
    with simplefoc_profile_lock:
        simplefoc_profile_state.update(kwargs)


def _profile_parse_status(line):
    if not line.startswith("{"):
        return None
    try:
        obj = json.loads(line)
    except Exception:
        return None
    _profile_set(last_status=obj)
    return obj


def _profile_send_locked(ser, cmd, read_for=0.3):
    cmd = str(cmd).strip()
    if not cmd:
        return []
    _profile_add_raw("TX " + cmd)
    ser.write((cmd + "\n").encode())
    ser.flush()
    lines = []
    end = time.time() + read_for
    while time.time() < end:
        line = ser.readline().decode(errors="ignore").strip()
        if not line:
            continue
        _profile_add_raw(line)
        _profile_parse_status(line)
        lines.append(line)
        if line.startswith("ERR"):
            break
    return lines


def _profile_read_until_locked(ser, deadline, stop_pred=None):
    lines = []
    while time.time() < deadline:
        with simplefoc_profile_lock:
            stop_requested = simplefoc_profile_stop_requested
        if stop_requested:
            _profile_send_locked(ser, "D", 0.2)
            _profile_add_raw("STOP_REQUESTED")
            break
        line = ser.readline().decode(errors="ignore").strip()
        if not line:
            continue
        _profile_add_raw(line)
        _profile_parse_status(line)
        lines.append(line)
        if line.startswith("ERR"):
            break
        if stop_pred and stop_pred(line):
            break
    return lines


def _profile_parse_log(lines):
    out = []
    in_log = False
    prev_t_s = None
    prev_rpm = None
    for line in lines:
        if line.startswith("LOG_BEGIN"):
            in_log = True
            continue
        if line.startswith("LOG_END"):
            break
        if not in_log or not line[:1].isdigit():
            continue
        parts = line.split(",")
        if len(parts) not in (4, 8):
            continue
        try:
            t_ms = float(parts[0])
            target = float(parts[1])
            enc_rpm = float(parts[2])
            uq = float(parts[3])
            ia = float(parts[4]) if len(parts) >= 8 else 0.0
            ib = float(parts[5]) if len(parts) >= 8 else 0.0
            ic_est = float(parts[6]) if len(parts) >= 8 else 0.0
            idc = float(parts[7]) if len(parts) >= 8 else 0.0
        except ValueError:
            continue
        target_rpm = target * 60.0 / (2.0 * math.pi)
        t_s = t_ms / 1000.0
        wheel_alpha = 0.0
        if prev_t_s is not None and prev_rpm is not None:
            dt = t_s - prev_t_s
            if dt > 0:
                wheel_alpha = (enc_rpm - prev_rpm) / dt
        prev_t_s = t_s
        prev_rpm = enc_rpm
        out.append({
            "t_ms": t_ms,
            "target": target,
            "target_rpm": target_rpm,
            "enc_rpm": enc_rpm,
            "enc_rpm_abs": abs(enc_rpm),
            "wheel_alpha_rpm_s": wheel_alpha,
            "wheel_alpha_abs": abs(wheel_alpha),
            "uq": uq,
            "ia": ia,
            "ib": ib,
            "ic_est": ic_est,
            "idc": idc,
            "ia_abs": abs(ia),
            "ib_abs": abs(ib),
            "ic_est_abs": abs(ic_est),
            "idc_abs": abs(idc),
            "rpm_error": abs(enc_rpm) - target_rpm,
            "rpm_error_abs": abs(abs(enc_rpm) - target_rpm),
        })
    return out


def _profile_begin(status):
    global simplefoc_profile_stop_requested
    with simplefoc_profile_lock:
        if simplefoc_profile_state["busy"]:
            return False
        simplefoc_profile_stop_requested = False
        simplefoc_profile_state.update({
            "busy": True,
            "status": status,
            "error": None,
            "raw": [],
        })
    return True


def _profile_finish(status=None, error=None):
    with simplefoc_profile_lock:
        if status is not None:
            simplefoc_profile_state["status"] = status
        simplefoc_profile_state["error"] = error
        simplefoc_profile_state["busy"] = False


def _profile_run_worker(params):
    if not _profile_begin("running"):
        return
    try:
        p = float(params.get("p", 0.2))
        i = float(params.get("i", 1.0))
        lpf = float(params.get("l", 0.05))
        voltage = float(params.get("v", 4.0))
        target = max(-52.36, min(float(params.get("target", 10.472)), 52.36))
        ramp = float(params.get("r", 2.0))
        hold = float(params.get("h", 5.0))
        ser = get_pico()
        if ser is None:
            raise RuntimeError("serial not available")
        with pico_lock:
            for cmd, delay in [
                ("D", 0.3),
                (f"P{p}", 0.2),
                (f"I{i}", 0.2),
                (f"L{lpf}", 0.2),
                (f"V{voltage}", 0.2),
                (f"R{ramp}", 0.2),
                (f"T{target}", 0.2),
                (f"H{hold}", 0.2),
            ]:
                lines = _profile_send_locked(ser, cmd, delay)
                if any(line.startswith("ERR") for line in lines):
                    _profile_send_locked(ser, "D", 0.2)
                    _profile_finish(lines[-1] if lines else "setup rejected")
                    return
            lines = _profile_send_locked(ser, "RUN", 0.2)
            if any(line.startswith("ERR") for line in lines):
                _profile_send_locked(ser, "D", 0.2)
                _profile_finish(lines[-1] if lines else "run rejected")
                return
            _profile_set(status="motion running, serial quiet")
            max_time = abs(target / max(ramp, 0.01)) + hold + abs(target / max(ramp, 0.01)) + 4
            lines = _profile_read_until_locked(
                ser,
                time.time() + max_time,
                lambda line: "RUN_DONE" in line or '"event":"done"' in line,
            )
            if any(line.startswith("ERR") for line in lines):
                _profile_send_locked(ser, "D", 0.2)
                _profile_finish(lines[-1])
                return
            _profile_set(status="dumping log")
            lines = _profile_send_locked(ser, "DUMP", 0.05)
            lines += _profile_read_until_locked(ser, time.time() + 8, lambda line: line.startswith("LOG_END"))
            with simplefoc_profile_lock:
                simplefoc_profile_state["last_log"] = _profile_parse_log(lines)
                count = len(simplefoc_profile_state["last_log"])
            _profile_send_locked(ser, "D", 0.3)
            _profile_finish(f"done, {count} log samples")
    except Exception as exc:
        _profile_finish("error", repr(exc))


def _profile_cmd_worker(cmds):
    if not _profile_begin("sending command"):
        return
    try:
        ser = get_pico()
        if ser is None:
            raise RuntimeError("serial not available")
        with pico_lock:
            for cmd, delay in cmds:
                _profile_send_locked(ser, cmd, delay)
        _profile_finish("idle")
    except Exception as exc:
        _profile_finish("error", repr(exc))


def _profile_dump_worker():
    if not _profile_begin("dumping"):
        return
    try:
        ser = get_pico()
        if ser is None:
            raise RuntimeError("serial not available")
        with pico_lock:
            lines = _profile_send_locked(ser, "DUMP", 0.05)
            lines += _profile_read_until_locked(ser, time.time() + 8, lambda line: line.startswith("LOG_END"))
        with simplefoc_profile_lock:
            simplefoc_profile_state["last_log"] = _profile_parse_log(lines)
            count = len(simplefoc_profile_state["last_log"])
        _profile_finish(f"done, {count} log samples")
    except Exception as exc:
        _profile_finish("error", repr(exc))


simplefoc_live_lock = threading.Lock()
simplefoc_live_stop = False
simplefoc_live_state = {
    "enabled": False,
    "mode": "angle",
    "status": "idle",
    "error": None,
    "body_angle": 0.0,
    "body_rate": 0.0,
    "body_zero": 0.0,
    "angle_target": 0.0,
    "rate_target_rpm": 0.0,
    "body_rate_target_dps": 0.0,
    "uq": 0.0,
    "kp": 3.0,
    "ki": 0.0,
    "kd": 0.8,
    "min_uq": 3.0,
    "max_uq": 5.0,
    "voltage": 12.0,
    "rate_ramp": 5.0,
    "angle_deadband": 4.0,
    "sweep_busy": False,
    "sweep_log": [],
    "angle_log": [],
    "min_wheel_uq": None,
    "min_body_uq": None,
    "wheel_rpm": 0.0,
    "wheel_alpha_rpm_s": 0.0,
    "gyro_zero_z": 0.0,
    "gyro_rate_z": 0.0,
}

simplefoc_torque_state = {
    "status": "idle",
    "busy": False,
    "error": None,
    "last_log": [],
    "body_log": [],
    "summary": {},
    "raw": [],
}


def _torque_set(**kwargs):
    with simplefoc_profile_lock:
        simplefoc_torque_state.update(kwargs)


def _torque_snapshot():
    with simplefoc_profile_lock:
        return dict(simplefoc_torque_state)


def _gyro_rate_z_dps():
    return float(sensor_data.get("gz", 0.0)) - float(simplefoc_live_state.get("gyro_zero_z", 0.0))


def _torque_run_worker(params):
    with simplefoc_profile_lock:
        if simplefoc_profile_state["busy"] or simplefoc_torque_state["busy"] or simplefoc_live_state.get("enabled"):
            simplefoc_torque_state.update({"status": "error", "error": "profile/control busy"})
            return
        simplefoc_torque_state.update({
            "status": "running",
            "busy": True,
            "error": None,
            "last_log": [],
            "body_log": [],
            "summary": {},
            "raw": [],
        })
    try:
        uq = max(-24.0, min(float(params.get("u", 1.0)), 24.0))
        voltage = max(0.0, min(float(params.get("v", simplefoc_live_state["voltage"])), 24.0))
        hold = max(0.1, min(float(params.get("h", 2.0)), 10.0))
        zero_body = bool(params.get("zero_body", True))
        zero_gyro = bool(params.get("zero_gyro", True))
        body_zero = _body_angle_raw() if zero_body else float(simplefoc_live_state.get("body_zero", _body_angle_raw()))
        gyro_zero = _live_calibrate_bias(0.5) if zero_gyro else float(simplefoc_live_state.get("gyro_zero_z", 0.0))
        _live_set(body_zero=body_zero, gyro_zero_z=gyro_zero)
        body_log = []
        ser = get_pico()
        if ser is None:
            raise RuntimeError("serial not available")
        with pico_lock:
            for cmd, delay in [
                ("D", 0.2),
                (f"V{voltage:.3f}", 0.2),
                (f"U{uq:.4f}", 0.2),
                (f"H{hold:.3f}", 0.2),
            ]:
                lines = _profile_send_locked(ser, cmd, delay)
                simplefoc_torque_state["raw"] = simplefoc_torque_state["raw"][-500:] + lines
                if any(line.startswith("ERR") for line in lines):
                    raise RuntimeError(lines[-1] if lines else "setup rejected")
            lines = _profile_send_locked(ser, "TU", 0.1)
            if any(line.startswith("ERR") for line in lines):
                raise RuntimeError(lines[-1] if lines else "torque rejected")
            start = time.monotonic()
            deadline = start + hold + 2.0
            prev_body = _body_angle_raw()
            prev_t = start
            done_lines = []
            old_timeout = ser.timeout
            ser.timeout = 0.001
            try:
                while time.monotonic() < deadline:
                    now = time.monotonic()
                    body_raw = _body_angle_raw()
                    body_angle = _wrap_delta_deg(body_raw - body_zero)
                    dt = max(0.001, now - prev_t)
                    body_rate_enc = _wrap_delta_deg(body_raw - prev_body) / dt
                    body_log.append({
                        "t": round(now - start, 4),
                        "body_angle": round(body_angle, 4),
                        "body_rate_enc": round(body_rate_enc, 4),
                        "body_rate_ads": round(_body_rate_dps(), 4),
                        "gyro_z": round(float(sensor_data.get("gz", 0.0)), 4),
                        "gyro_z_zeroed": round(float(sensor_data.get("gz", 0.0)) - gyro_zero, 4),
                        "uq": round(uq, 4),
                    })
                    prev_body = body_raw
                    prev_t = now
                    line = ser.readline().decode(errors="ignore").strip()
                    if line:
                        done_lines.append(line)
                        _profile_add_raw(line)
                        if "TORQUE_DONE" in line or '"event":"torque_done"' in line:
                            break
                    time.sleep(0.02)
            finally:
                ser.timeout = old_timeout
            lines = _profile_send_locked(ser, "DUMP", 0.05)
            lines += _profile_read_until_locked(ser, time.time() + 8, lambda line: line.startswith("LOG_END"))
            wheel_log = _profile_parse_log(lines)
            _profile_send_locked(ser, "D", 0.2)
        # The first encoder velocity sample after enabling can occasionally contain
        # SimpleFOC's stale velocity estimate. Keep it in the raw log but exclude
        # physically absurd spikes from the control summary.
        valid_wheel_log = [
            x for x in wheel_log[1:]
            if abs(x.get("enc_rpm", 0.0)) < 3000.0 and abs(x.get("wheel_alpha_rpm_s", 0.0)) < 20000.0
        ]
        max_wheel_alpha = max((abs(x.get("wheel_alpha_rpm_s", 0.0)) for x in valid_wheel_log), default=0.0)
        max_wheel_rpm = max((abs(x.get("enc_rpm", 0.0)) for x in valid_wheel_log), default=0.0)
        body_delta = 0.0
        if body_log:
            body_delta = body_log[-1]["body_angle"] - body_log[0]["body_angle"]
        max_body_rate = max((abs(x.get("body_rate_enc", 0.0)) for x in body_log), default=0.0)
        max_gyro = max((abs(x.get("gyro_z_zeroed", 0.0)) for x in body_log), default=0.0)
        _torque_set(
            status="done",
            busy=False,
            error=None,
            last_log=wheel_log,
            body_log=body_log,
            summary={
                "uq": uq,
                "voltage": voltage,
                "hold_s": hold,
                "max_wheel_alpha_rpm_s": max_wheel_alpha,
                "max_wheel_rpm": max_wheel_rpm,
                "body_delta_deg": body_delta,
                "max_body_rate_dps": max_body_rate,
                "max_gyro_z_dps": max_gyro,
                "gyro_zero_z": gyro_zero,
            },
        )
    except Exception as exc:
        try:
            _live_send("U0")
            _live_send("D")
        except Exception:
            pass
        _torque_set(status="error", busy=False, error=repr(exc))


def _live_set(**kwargs):
    with simplefoc_live_lock:
        simplefoc_live_state.update(kwargs)


def _live_snapshot():
    with simplefoc_live_lock:
        return dict(simplefoc_live_state)


def _live_send_locked(ser, cmd):
    ser.write((cmd.rstrip("\n") + "\n").encode())


def _live_send(cmd):
    ser = get_pico()
    if ser is None:
        raise RuntimeError("serial not available")
    with pico_lock:
        _live_send_locked(ser, cmd)


def _live_calibrate_bias(duration=1.0):
    samples = []
    deadline = time.time() + duration
    while time.time() < deadline:
        samples.append(float(sensor_data.get("gz", 0.0)))
        time.sleep(0.02)
    return sum(samples) / len(samples) if samples else 0.0


def _body_angle_raw():
    return float(sensor_data.get("analog_mechanical_deg", sensor_data.get("angle", 0.0)))


def _body_angle_from_zero(zero):
    return _wrap_delta_deg(_body_angle_raw() - zero)


def _body_rate_dps():
    return float(sensor_data.get("rpm", 0.0)) * 6.0


def _read_stm_status_locked(ser, read_for=0.25):
    ser.write(b"S\n")
    deadline = time.time() + read_for
    last = None
    while time.time() < deadline:
        line = ser.readline().decode(errors="ignore").strip()
        if not line:
            continue
        if line.startswith("{") and line.endswith("}"):
            try:
                last = json.loads(line)
            except Exception:
                pass
    return last or {}


def _breakaway_sweep_worker(config):
    if simplefoc_live_state.get("enabled"):
        _live_set(status="error", error="stop angle/rate control before sweep")
        return
    with simplefoc_profile_lock:
        if simplefoc_profile_state["busy"]:
            _live_set(status="error", error="profile runner busy")
            return
    start = abs(float(config.get("start", 0.1)))
    stop = abs(float(config.get("stop", 3.0)))
    step = abs(float(config.get("step", 0.05)))
    pulse_s = max(0.1, min(float(config.get("pulse_s", 0.5)), 2.0))
    rest_s = max(0.1, min(float(config.get("rest_s", 0.5)), 2.0))
    voltage = max(0.0, min(float(config.get("voltage", simplefoc_live_state["voltage"])), 24.0))
    wheel_rpm_threshold = abs(float(config.get("wheel_rpm_threshold", 2.0)))
    body_delta_threshold = abs(float(config.get("body_delta_threshold", 0.2)))
    body_rate_threshold = abs(float(config.get("body_rate_threshold", 1.0)))
    direction = 1.0 if float(config.get("direction", 1.0)) >= 0 else -1.0
    out = []
    min_wheel = None
    min_body = None
    _live_set(
        sweep_busy=True, status="breakaway sweep", error=None,
        sweep_log=[], min_wheel_uq=None, min_body_uq=None,
    )
    try:
        ser = get_pico()
        if ser is None:
            raise RuntimeError("serial not available")
        with pico_lock:
            _live_send_locked(ser, "D")
            time.sleep(0.2)
            _live_send_locked(ser, f"V{voltage:.3f}")
            _live_send_locked(ser, "MA")
            _live_send_locked(ser, "U0")
            _live_send_locked(ser, "E")
            uq = start
            while uq <= stop + 1e-9:
                signed_uq = direction * uq
                body_start = _body_angle_raw()
                st0 = _read_stm_status_locked(ser, 0.15)
                rpm_start = float(st0.get("enc_rpm", 0.0) or 0.0)
                _live_send_locked(ser, f"U{signed_uq:.4f}")
                max_wheel_rpm = 0.0
                max_body_rate = 0.0
                prev_body = body_start
                prev_t = time.monotonic()
                deadline = time.time() + pulse_s
                while time.time() < deadline:
                    time.sleep(0.04)
                    body_now = _body_angle_raw()
                    now = time.monotonic()
                    dt = max(0.001, now - prev_t)
                    body_rate = _wrap_delta_deg(body_now - prev_body) / dt
                    max_body_rate = max(max_body_rate, abs(body_rate))
                    prev_body = body_now
                    prev_t = now
                    st = _read_stm_status_locked(ser, 0.04)
                    rpm_now = float(st.get("enc_rpm", 0.0) or 0.0)
                    max_wheel_rpm = max(max_wheel_rpm, abs(rpm_now - rpm_start))
                body_end = _body_angle_raw()
                body_delta = _wrap_delta_deg(body_end - body_start)
                _live_send_locked(ser, "U0")
                moved_wheel = max_wheel_rpm >= wheel_rpm_threshold
                moved_body = (
                    abs(body_delta) >= body_delta_threshold
                    or (abs(body_delta) >= body_delta_threshold * 0.25 and max_body_rate >= body_rate_threshold)
                )
                if min_wheel is None and moved_wheel:
                    min_wheel = uq
                if min_body is None and moved_body:
                    min_body = uq
                out.append({
                    "uq": round(signed_uq, 4),
                    "max_wheel_rpm_delta": round(max_wheel_rpm, 3),
                    "body_delta_deg": round(body_delta, 4),
                    "max_body_rate_dps": round(max_body_rate, 4),
                    "wheel_breakaway": moved_wheel,
                    "body_response": moved_body,
                })
                _live_set(sweep_log=list(out), min_wheel_uq=min_wheel, min_body_uq=min_body)
                time.sleep(rest_s)
                if min_wheel is not None and min_body is not None:
                    break
                uq += step
            _live_send_locked(ser, "U0")
            _live_send_locked(ser, "D")
        _live_set(status="sweep done")
    except Exception as exc:
        _live_set(status="error", error=repr(exc))
        try:
            _live_send("U0")
            _live_send("D")
        except Exception:
            pass
    finally:
        _live_set(sweep_busy=False, enabled=False, uq=0.0)


def _simplefoc_live_worker(config):
    global simplefoc_live_stop
    with simplefoc_profile_lock:
        if simplefoc_profile_state["busy"]:
            _live_set(status="error", error="profile runner busy")
            return
    mode = str(config.get("mode", "angle"))
    voltage = float(config.get("voltage", simplefoc_live_state["voltage"]))
    rate_ramp = float(config.get("rate_ramp", simplefoc_live_state["rate_ramp"]))
    angle_target = float(config.get("angle_target", simplefoc_live_state["angle_target"]))
    rate_target_rpm = max(-1000.0, min(float(config.get("rate_target_rpm", simplefoc_live_state["rate_target_rpm"])), 1000.0))
    body_rate_target_dps = max(-60.0, min(float(config.get("body_rate_target_dps", simplefoc_live_state.get("body_rate_target_dps", 0.0))), 60.0))
    kp = float(config.get("kp", simplefoc_live_state["kp"]))
    ki = float(config.get("ki", simplefoc_live_state["ki"]))
    kd = float(config.get("kd", simplefoc_live_state["kd"]))
    min_uq = abs(float(config.get("min_uq", simplefoc_live_state["min_uq"])))
    max_uq = abs(float(config.get("max_uq", simplefoc_live_state["max_uq"])))
    angle_deadband = abs(float(config.get("angle_deadband", simplefoc_live_state.get("angle_deadband", 1.0))))
    max_uq = max(0.1, min(max_uq, 24.0))
    min_uq = min(min_uq, max_uq)
    voltage = max(0.0, min(voltage, 24.0))
    rate_ramp = max(0.01, min(rate_ramp, 50.0))
    rate_target_rads = rate_target_rpm * 2.0 * math.pi / 60.0

    simplefoc_live_stop = False
    body_zero = float(config.get("body_zero", simplefoc_live_state.get("body_zero", _body_angle_raw())))
    prev_body_raw = _body_angle_raw()
    body_angle_unwrapped = _wrap_delta_deg(prev_body_raw - body_zero)
    prev_body_angle = body_angle_unwrapped
    integral = 0.0
    last = time.monotonic()
    last_send = 0.0
    last_status_poll = 0.0
    last_wheel_rpm_sample_t = 0.0
    last_voltage_send = 0.0
    open_start_voltage = 3.0
    open_spool_seconds = 5.0
    open_boost_seconds = 2.0
    open_spool_rpm = 10.0
    body_rate_ref = 0.0
    last_uq_cmd = 0.0
    body_rate_filt = 0.0
    integ_pos = 0.0
    body_rate_d_filt = 0.0
    angle_achieved = False
    angle_achieved_count = 0
    breakaway_until = 0.0
    wheel_rpm = 0.0
    wheel_alpha_rpm_s = 0.0
    breakaway_used = False
    try:
        ser = get_pico()
        if ser is None:
            raise RuntimeError("serial not available")
        with pico_lock:
            _live_send_locked(ser, "D")
            if mode == "rate":
                _live_send_locked(ser, f"V{voltage:.3f}")
                _live_send_locked(ser, "MR")
                _live_send_locked(ser, f"R{rate_ramp:.3f}")
                _live_send_locked(ser, f"T{rate_target_rads:.5f}")
            elif mode in ("angle_open", "body_rate_open"):
                _live_send_locked(ser, f"V{min(voltage, open_start_voltage):.3f}")
                _live_send_locked(ser, "MO")
                _live_send_locked(ser, f"R{rate_ramp:.3f}")
                _live_send_locked(ser, "T0")
            else:
                # Torque mode - wheel must already be spinning (prespin externally)
                _live_send_locked(ser, f"V{voltage:.3f}")
                _live_send_locked(ser, "MA")
                _live_send_locked(ser, "U0")
            _live_send_locked(ser, "E")
        _live_set(
            enabled=True, mode=mode, status="running", error=None,
            body_angle=prev_body_angle, body_rate=0.0, body_zero=body_zero, angle_target=angle_target,
            rate_target_rpm=rate_target_rpm, body_rate_target_dps=body_rate_target_dps, uq=0.0,
            kp=kp, ki=ki, kd=kd, min_uq=min_uq, max_uq=max_uq,
            voltage=voltage, rate_ramp=rate_ramp, angle_log=[],
        )
        angle_log = []
        run_start = time.monotonic()

        while True:
            with simplefoc_live_lock:
                if simplefoc_live_stop:
                    break
                # Allow live retuning from config endpoint.
                new_angle_target = float(simplefoc_live_state["angle_target"])
                if abs(new_angle_target - angle_target) > 0.5:
                    angle_achieved = False
                    angle_achieved_count = 0
                angle_target = new_angle_target
                rate_target_rpm = max(-1000.0, min(float(simplefoc_live_state["rate_target_rpm"]), 1000.0))
                body_rate_target_dps = max(-60.0, min(float(simplefoc_live_state.get("body_rate_target_dps", body_rate_target_dps)), 60.0))
                kp = float(simplefoc_live_state["kp"])
                ki = float(simplefoc_live_state["ki"])
                kd = float(simplefoc_live_state["kd"])
                min_uq = abs(float(simplefoc_live_state["min_uq"]))
                max_uq = max(0.1, abs(float(simplefoc_live_state["max_uq"])))
                min_uq = min(min_uq, max_uq)
                angle_deadband = abs(float(simplefoc_live_state.get("angle_deadband", angle_deadband)))
            now = time.monotonic()
            dt = max(0.001, min(now - last, 0.1))
            last = now
            body_raw = _body_angle_raw()
            body_delta = _wrap_delta_deg(body_raw - prev_body_raw)
            prev_body_raw = body_raw
            body_angle_unwrapped += body_delta
            body_angle = body_angle_unwrapped
            encoder_rate_raw = body_delta / dt
            ads_rate_raw = _body_rate_dps()
            gyro_rate_z = _gyro_rate_z_dps()
            # Body-rate control needs to react to the actual base encoder
            # motion. Keep gyro in the blend, but make the encoder derivative
            # the primary signal so Uq follows measured body rate error.
            body_rate_raw = gyro_rate_z
            alpha_rate = min(1.0, dt / (0.10 + dt))
            body_rate_filt += alpha_rate * (body_rate_raw - body_rate_filt)
            body_rate = body_rate_filt
            prev_body_angle = body_angle
            uq = 0.0
            if mode == "angle":
                # Cascaded controller adapted from reference MACE code:
                #   Outer PID (angle -> rate ref), Inner PI (rate -> Uq)
                # Reference gains: Kp_pos=0.8, Ki_pos=0.05, Kd_pos=0.10
                #   Inner: KR_P=58.8, KR_I=4.0
                # We map PWM duty to Uq voltage: PWM_MAX(204) ~ max_uq

                e_theta = angle_target - body_angle

                # Near target: zero integrators to prevent windup, but keep controller active
                if abs(e_theta) <= angle_deadband and abs(body_rate) < 2.0:
                    pass  # let integrators work normally near target
                    pass

                # --- Outer loop: angle PID -> omega_ref ---
                # Runs every iteration (our loop is ~50Hz, ref outer was 100Hz)
                RATE_REF_MAX = 30.0   # deg/s cap on rate reference
                RATE_REF_SLEW = 20.0  # deg/s^2 slew limit

                # PID: kp * error + ki * integral + kd * (filtered derivative on measurement)
                up_pos = kp * e_theta

                # Integral with anti-windup: only integrate when output not saturating
                ui_pos_candidate = integ_pos + ki * dt * e_theta

                # D term on measurement (filtered gyro rate), not on error
                body_rate_d_filt += min(1.0, dt / (0.10 + dt)) * (body_rate - body_rate_d_filt)
                ud_pos = -kd * body_rate_d_filt

                v_outer = up_pos + integ_pos + ud_pos

                # Clamp to rate ref limits
                v_sat = max(-RATE_REF_MAX, min(v_outer, RATE_REF_MAX))

                # Slew rate limit on omega_ref
                max_step = RATE_REF_SLEW * dt
                step = max(-max_step, min(v_sat - body_rate_ref, max_step))
                body_rate_ref = body_rate_ref + step

                # Anti-windup: only accept integration when not clamped
                if abs(v_outer - v_sat) < 0.01:
                    integ_pos = ui_pos_candidate
                # Clamp integrator
                integ_pos = max(-50.0, min(integ_pos, 50.0))

                # --- Inner loop: rate PI -> Uq ---
                # Reference: KR_P=58.8, KR_I=4.0 at PWM_MAX=204
                # Scale to our Uq: factor = max_uq / 204 ~ 0.059 for max_uq=12
                # Effective: KR_P_uq = 58.8 * 0.059 = 3.47, KR_I_uq = 4.0 * 0.059 = 0.24
                # But our rate is deg/s not rad/s, so divide by 57.3:
                # KR_P_eff = 3.47 / 57.3 = 0.0606, KR_I_eff = 0.24 / 57.3 = 0.0042
                # Use these as base, scale by max_uq/12 for different authority
                uq_scale = max_uq / 12.0
                KR_P_eff = 0.30 * uq_scale
                KR_I_eff = 0.02 * uq_scale

                e_omega = body_rate_ref - body_rate
                up_rate = KR_P_eff * e_omega

                ui_rate_candidate = integral + KR_I_eff * dt * e_omega
                raw_uq = -(up_rate + integral)

                # Clamp
                u_sat = max(-max_uq, min(raw_uq, max_uq))

                # Anti-windup: only integrate when not saturating
                if abs(raw_uq - u_sat) < 0.01:
                    integral = ui_rate_candidate
                integral = max(-max_uq, min(integral, max_uq))

                # Dead zone: ensure minimum effort when wheel is slow
                if abs(u_sat) > 0.01 and abs(e_theta) > angle_deadband:
                    u_sat = math.copysign(max(abs(u_sat), min_uq), u_sat)

                uq = u_sat
                last_uq_cmd = uq
                # Soft desaturation: prevent wheel from building past 400,
                # gently bring it back if it exceeds 400
                wr_abs = abs(wheel_rpm)
                if wr_abs > 400:
                    # Don't allow torque that accelerates the wheel further
                    would_accelerate = (wheel_rpm > 0 and uq < 0) or (wheel_rpm < 0 and uq > 0)
                    if would_accelerate:
                        # Scale down torque that would accelerate wheel
                        desat_scale = max(0.0, 1.0 - (wr_abs - 400) / 100.0)
                        uq = uq * desat_scale
                    # Above 450, actively apply gentle reverse torque
                    if wr_abs > 450:
                        desat_uq = math.copysign(min_uq * 0.5, wheel_rpm)
                        uq = desat_uq
                        integral = 0.0
                        integ_pos = 0.0
                # Hard safety at 500 (STM32 has 550 too)
                if wr_abs > 500:
                    uq = 0.0
                    last_uq_cmd = 0.0
                    integral = 0.0
                    integ_pos = 0.0
                if now - last_send >= 0.04:
                    _live_send(f"U{uq:.3f}")
                    last_send = now
            elif mode == "body_rate":
                body_rate_ref = body_rate_target_dps
                rate_error = body_rate_ref - body_rate
                if abs(body_rate_ref) <= 0.2 and abs(body_rate) < 1.0:
                    integral = 0.0
                    raw_uq = 0.0
                else:
                    # Drain integral when overshooting target (body faster than target in same direction)
                    overshoot = (body_rate_ref * body_rate > 0 and abs(body_rate) > abs(body_rate_ref) + 2.0)
                    if overshoot:
                        integral *= max(0.0, 1.0 - 3.0 * dt)
                    elif abs(rate_error) < 40.0:
                        integral += rate_error * dt
                    else:
                        pass
                    integral = max(-20.0, min(integral, 20.0))
                    # Reference-style inner rate loop -> signed motor effort.
                    # Positive body rate needs negative wheel torque here.
                    # Directional gain scheduling:
                    # - When torque opposes wheel (decelerating): gentle gains
                    # - When torque aids wheel (accelerating): normal gains
                    wr_abs = abs(wheel_rpm)
                    wr_frac = min(1.0, wr_abs / 200.0)
                    base_uq = -((0.55 * kp) * rate_error + (0.18 * ki) * integral)
                    # Check if torque is decelerating the wheel (opposing its direction)
                    decelerating = (wheel_rpm > 0 and base_uq > 0) or (wheel_rpm < 0 and base_uq < 0)
                    if decelerating and wr_abs < 200:
                        gain_scale = 0.15 + 0.85 * wr_frac
                    else:
                        gain_scale = 1.0
                    raw_uq = base_uq * gain_scale
                    # Deadband compensation only helps overcome the base
                    # bearing. It must not replace the PI output once the error
                    # grows large enough to demand more effort.
                    if abs(body_rate_ref) > 0.2 and abs(rate_error) > 0.4 and abs(raw_uq) < min_uq:
                        raw_uq = math.copysign(min_uq, raw_uq if abs(raw_uq) > 1e-6 else -rate_error)

                uq = max(-max_uq, min(raw_uq, max_uq))
                # Slower slew rate for first 5s to prevent overshoot from primed start
                elapsed_s = now - run_start
                if elapsed_s < 5.0:
                    max_uq_step = 2.0 * dt
                else:
                    max_uq_step = 5.0 * dt
                uq = last_uq_cmd + max(-max_uq_step, min(uq - last_uq_cmd, max_uq_step))
                last_uq_cmd = uq
                # HARD SAFETY: kill torque if wheel exceeds 600 RPM
                if abs(wheel_rpm) > 500:
                    uq = 0.0
                    last_uq_cmd = 0.0
                    integral = 0.0
                    if hasattr(test_angle, '__func__'):
                        pass
                    try:
                        integ_pos = 0.0
                    except NameError:
                        pass
                if now - last_send >= 0.04:
                    _live_send(f"U{uq:.3f}")
                    last_send = now
            elif mode in ("angle_open", "body_rate_open"):
                # Start open-loop wheel velocity gently: the old MACE output was
                # motor effort, not a full-strength velocity target. Ramping
                # voltage separately avoids snapping the wheel before the base
                # has started moving.
                elapsed = now - run_start
                if elapsed < open_spool_seconds:
                    open_voltage = open_start_voltage
                else:
                    # Raise voltage before asking for the heavy speed ramp.
                    # Otherwise open-loop velocity can outrun the loaded wheel
                    # while the phase voltage is still too low, which just
                    # makes the motor whirr/slip.
                    open_voltage = min(voltage, open_start_voltage + 4.0 * (elapsed - open_spool_seconds))
                if now - last_voltage_send >= 0.2:
                    _live_send(f"V{open_voltage:.3f}")
                    last_voltage_send = now
                if mode == "angle_open":
                    error = angle_target - body_angle
                    integral += error * dt
                    integral = max(-100.0, min(integral, 100.0))
                    rate_cap = 14.0
                    rate_slew = 30.0
                    desired_body_rate = max(-rate_cap, min(kp * error - kd * body_rate, rate_cap))
                    max_rate_step = rate_slew * dt
                    body_rate_ref += max(-max_rate_step, min(desired_body_rate - body_rate_ref, max_rate_step))
                else:
                    body_rate_ref = body_rate_target_dps

                rate_error = body_rate_ref - body_rate
                # Match the old MACE structure: inner rate controller creates a
                # signed motor effort. Here that effort maps to open-loop wheel
                # velocity instead of brushed PWM duty. Positive body-rate demand
                # needs negative wheel velocity on this rig.
                integral += rate_error * dt
                integral = max(-100.0, min(integral, 100.0))
                effort = kp * 0.35 * rate_error + ki * 0.05 * integral
                effort = max(-1.0, min(effort, 1.0))
                if abs(rate_error) < 0.5:
                    effort = 0.0
                wheel_rpm_cmd = -effort * max(50.0, abs(rate_target_rpm))
                if (
                    mode == "angle_open"
                    and elapsed < open_spool_seconds + open_boost_seconds
                    and abs(angle_target - body_angle) > angle_deadband
                ):
                    # Give the loaded wheel a short low-power spool before the
                    # angle loop is allowed to demand the heavy correction. Then
                    # hold the same low speed briefly while voltage catches up.
                    # The direction matches the current angle error mapping.
                    wheel_rpm_cmd = -math.copysign(open_spool_rpm, angle_target - body_angle)
                rate_target_rads = wheel_rpm_cmd * 2.0 * math.pi / 60.0
                last_uq_cmd = wheel_rpm_cmd
                if now - last_send >= 0.04:
                    _live_send(f"T{rate_target_rads:.5f}")
                    last_send = now
            elif now - last_send >= 0.2:
                # Safety cap for rate mode too
                if abs(wheel_rpm) > 500:
                    _live_send("T0")
                else:
                    rate_target_rads = rate_target_rpm * 2.0 * math.pi / 60.0
                    _live_send(f"T{rate_target_rads:.5f}")
                last_send = now
            if now - last_status_poll >= 0.2:
                try:
                    ser_status = get_pico()
                    if ser_status is not None:
                        with pico_lock:
                            st = _read_stm_status_locked(ser_status, 0.03)
                        if st:
                            rpm_now = float(st.get("enc_rpm", wheel_rpm) or 0.0)
                            if last_wheel_rpm_sample_t > 0.0:
                                sample_dt = max(1e-3, now - last_wheel_rpm_sample_t)
                                wheel_alpha_rpm_s = (rpm_now - wheel_rpm) / sample_dt
                            wheel_rpm = rpm_now
                            last_wheel_rpm_sample_t = now
                    last_status_poll = now
                except Exception:
                    last_status_poll = now
            if mode in ("angle", "body_rate", "angle_open", "body_rate_open"):
                angle_log.append({
                    "t": round(now - run_start, 3),
                    "target": round(angle_target, 3),
                    "body_angle": round(body_angle, 3),
                    "body_raw": round(body_raw, 3),
                    "body_rate": round(body_rate, 3),
                    "body_rate_raw": round(body_rate_raw, 3),
                    "gyro_rate_z": round(gyro_rate_z, 3),
                    "body_rate_ref": round(body_rate_ref, 3),
                    "wheel_alpha_cmd": round(last_uq_cmd, 3) if mode in ("body_rate", "angle_open", "body_rate_open") else 0.0,
                    "wheel_rpm": round(wheel_rpm, 3),
                    "wheel_alpha_rpm_s": round(wheel_alpha_rpm_s, 3),
                    "error": round(angle_target - body_angle, 3) if mode == "angle" else round(body_rate_ref - body_rate, 3),
                    "uq": round(uq, 4),
                })
                if len(angle_log) > 1500:
                    angle_log = angle_log[-1500:]
                if len(angle_log) % 5 == 0:
                    _live_set(angle_log=list(angle_log))
            _live_set(body_angle=round(body_angle, 3), body_rate=round(body_rate, 3), gyro_rate_z=round(gyro_rate_z, 3), wheel_rpm=round(wheel_rpm, 3), wheel_alpha_rpm_s=round(wheel_alpha_rpm_s, 3), uq=round(uq, 4))
            time.sleep(0.02)
    except Exception as exc:
        _live_set(status="error", error=repr(exc))
    finally:
        try:
            _live_send("U0")
            _live_send("T0")
            _live_send("D")
        except Exception:
            pass
        _live_set(enabled=False, status="idle")


@app.route("/simplefoc/profile/state")
def simplefoc_profile_state_route():
    with simplefoc_profile_lock:
        return jsonify(dict(simplefoc_profile_state))


@app.route("/simplefoc/profile/run", methods=["POST"])
def simplefoc_profile_run_route():
    with simplefoc_profile_lock:
        if simplefoc_profile_state["busy"]:
            return jsonify({"ok": False, "error": "busy"}), 409
    threading.Thread(target=_profile_run_worker, args=(request.json or {},), daemon=True).start()
    return jsonify({"ok": True})


@app.route("/simplefoc/profile/calibrate", methods=["POST"])
def simplefoc_profile_calibrate_route():
    with simplefoc_profile_lock:
        if simplefoc_profile_state["busy"]:
            return jsonify({"ok": False, "error": "busy"}), 409
    threading.Thread(target=_profile_cmd_worker, args=([("D", 0.3), ("G", 8.0), ("S", 0.3)],), daemon=True).start()
    return jsonify({"ok": True})


@app.route("/simplefoc/profile/stop", methods=["POST"])
def simplefoc_profile_stop_route():
    global simplefoc_profile_stop_requested
    with simplefoc_profile_lock:
        busy = simplefoc_profile_state["busy"]
        simplefoc_profile_stop_requested = True
    if not busy:
        threading.Thread(target=_profile_cmd_worker, args=([("D", 0.3)],), daemon=True).start()
    return jsonify({"ok": True})


@app.route("/simplefoc/profile/dump", methods=["POST"])
def simplefoc_profile_dump_route():
    with simplefoc_profile_lock:
        if simplefoc_profile_state["busy"]:
            return jsonify({"ok": False, "error": "busy"}), 409
    threading.Thread(target=_profile_dump_worker, daemon=True).start()
    return jsonify({"ok": True})


@app.route("/simplefoc/control/state")
def simplefoc_control_state_route():
    return jsonify(_live_snapshot())


@app.route("/simplefoc/control/start", methods=["POST"])
def simplefoc_control_start_route():
    with simplefoc_live_lock:
        if simplefoc_live_state["enabled"]:
            return jsonify({"ok": False, "error": "control already running"}), 409
    threading.Thread(target=_simplefoc_live_worker, args=(request.json or {},), daemon=True).start()
    return jsonify({"ok": True})


@app.route("/simplefoc/control/config", methods=["POST"])
def simplefoc_control_config_route():
    data = request.json or {}
    allowed = {
        "mode", "angle_target", "rate_target_rpm", "body_rate_target_dps", "kp", "ki", "kd",
        "min_uq", "max_uq", "voltage", "rate_ramp",
    }
    update = {k: data[k] for k in allowed if k in data}
    _live_set(**update)
    return jsonify({"ok": True, **_live_snapshot()})


@app.route("/simplefoc/control/zero", methods=["POST"])
def simplefoc_control_zero_route():
    zero = _body_angle_raw()
    gyro_zero = _live_calibrate_bias(0.8)
    _live_set(body_angle=0.0, body_rate=0.0, gyro_rate_z=0.0, body_zero=zero, gyro_zero_z=gyro_zero, uq=0.0)
    return jsonify({"ok": True, **_live_snapshot()})


@app.route("/simplefoc/control/stop", methods=["POST"])
def simplefoc_control_stop_route():
    global simplefoc_live_stop
    with simplefoc_live_lock:
        simplefoc_live_stop = True
    try:
        _live_send("U0")
        _live_send("T0")
        _live_send("D")
    except Exception:
        pass
    _live_set(enabled=False, status="idle", uq=0.0)
    return jsonify({"ok": True, **_live_snapshot()})


@app.route("/simplefoc/control/breakaway", methods=["POST"])
def simplefoc_control_breakaway_route():
    with simplefoc_live_lock:
        if simplefoc_live_state.get("sweep_busy"):
            return jsonify({"ok": False, "error": "sweep busy"}), 409
        if simplefoc_live_state.get("enabled"):
            return jsonify({"ok": False, "error": "stop control first"}), 409
    threading.Thread(target=_breakaway_sweep_worker, args=(request.json or {},), daemon=True).start()
    return jsonify({"ok": True})


@app.route("/simplefoc/torque/state")
def simplefoc_torque_state_route():
    return jsonify(_torque_snapshot())


@app.route("/simplefoc/torque/run", methods=["POST"])
def simplefoc_torque_run_route():
    threading.Thread(target=_torque_run_worker, args=(request.json or {},), daemon=True).start()
    return jsonify({"ok": True})


@app.route("/pwm", methods=["POST"])
def pwm():
    """Set PWM pulse width on any named channel, with safety clamps.

    Body: {
        "channel": "B1",
        "pw": 1500,
        "seq": 42,            # optional monotonic sequence number
        "bypass_clamp": false # optional: used by startup/all_off
    }

    Safety layers:
      1. Per-channel lock serializes concurrent writes.
      2. Sequence number rejects out-of-order or duplicate commands.
      3. Max-delta clamp caps how far pw can jump from the last write.
    """
    data = request.json or {}
    name = data.get("channel", "").upper()
    requested_pw = int(data.get("pw", 0))
    seq = int(data.get("seq", -1))
    bypass = bool(data.get("bypass_clamp", False))

    if name not in CHANNELS:
        return jsonify({"ok": False, "error": f"unknown channel: {name}"}), 400
    ch = CHANNELS[name]
    requested_pw = max(0, min(2500, requested_pw))

    with _servo_locks[name]:
        if seq != -1 and seq <= _servo_last_seq[name]:
            return jsonify({
                "ok": False,
                "error": "stale sequence",
                "channel": name,
                "last_seq": _servo_last_seq[name],
            }), 409

        last_pw = _servo_last_pw[name]
        clamped = False
        pw_to_write = requested_pw
        # L1: bypass_clamp is only valid for "off" (pw=0). Reject misuse.
        if bypass and requested_pw != 0:
            return jsonify({
                "ok": False,
                "error": "bypass_clamp is only valid for pw=0",
                "channel": name,
            }), 400
        # C3: clamp always applies unless bypass, even across the 0 boundary.
        # This closes the loophole where pw=0 -> nonzero could jump unbounded.
        if not bypass and last_pw is not None:
            delta = requested_pw - last_pw
            if delta > SERVO_MAX_DELTA_US:
                pw_to_write = last_pw + SERVO_MAX_DELTA_US
                clamped = True
            elif delta < -SERVO_MAX_DELTA_US:
                pw_to_write = last_pw - SERVO_MAX_DELTA_US
                clamped = True

        write_ok = True
        if pw_to_write == 0:
            try:
                pca_off(ch)
            except Exception:
                _pca_bump("write")
                write_ok = False
        else:
            write_ok = pca_set_pulse_us(ch, pw_to_write)

        if not write_ok:
            # M-D: hardware did not accept the write. Do NOT update last_pw
            # or last_seq; the caller's next attempt will be rejected unless
            # it retries with the same seq. Return 503 so upstream retries.
            return jsonify({
                "ok": False,
                "error": "hardware write failed",
                "channel": name,
                "last_seq": _servo_last_seq[name],
            }), 503

        _servo_last_pw[name] = pw_to_write
        if seq != -1:
            _servo_last_seq[name] = seq

    return jsonify({
        "ok": True,
        "channel": name,
        "ch": ch,
        "pw": pw_to_write,
        "requested_pw": requested_pw,
        "clamped": clamped,
        "last_seq": _servo_last_seq[name],
    })


@app.route("/pwm_seed", methods=["POST"])
def pwm_seed():
    """Seed _servo_last_pw for an unpowered channel.

    Intended for groundstation boot: after a PCA power-cycle the register
    reads 0 (no PWM output -> servo unpowered). The ordinary /pwm path
    would 50us-staircase from 0, slamming the servo to an extreme before
    reaching neutral. /pwm_seed writes the requested pw directly to the
    PCA and sets last_pw in one step.

    Safety: rejected if the channel already has a live signal
    (_servo_last_pw not in (None, 0)). That prevents the seed path from
    being used to bypass the 50us clamp on a moving servo.

    Body: {"channel": "B1", "pw": 1160}
    """
    data = request.json or {}
    name = data.get("channel", "").upper()
    pw = int(data.get("pw", 0))
    if name not in CHANNELS:
        return jsonify({"ok": False, "error": f"unknown channel: {name}"}), 400
    if pw <= 0 or pw > 2500:
        return jsonify({"ok": False, "error": "pw must be in (0, 2500]"}), 400
    ch = CHANNELS[name]
    with _servo_locks[name]:
        current = _servo_last_pw[name]
        if current not in (None, 0):
            return jsonify({
                "ok": False,
                "error": "channel already has a live signal; use /pwm instead",
                "last_pw": current,
            }), 409
        ok = pca_set_pulse_us(ch, pw)
        if not ok:
            return jsonify({"ok": False, "error": "pca write failed"}), 503
        _servo_last_pw[name] = pw
    return jsonify({"ok": True, "channel": name, "pw": pw})

@app.route("/pwm/off", methods=["POST"])
def pwm_all_off():
    """Turn all PCA9685 channels off."""
    pca_all_off()
    return jsonify({"ok": True})



@app.route("/pwm_health")
def pwm_health():
    """Telemetry for the servo write path. Snapshots taken under the health
    lock so the reader sees coherent counters + state."""
    with _servo_health_lock:
        we = _pca_write_errors
        rm = _pca_readback_mismatches
    # Per-channel state: take each channel's lock briefly to snapshot.
    snap_pw = {}
    snap_seq = {}
    for name in CHANNELS:
        with _servo_locks[name]:
            snap_pw[name] = _servo_last_pw[name]
            snap_seq[name] = _servo_last_seq[name]
    return jsonify({
        "write_errors": we,
        "readback_mismatches": rm,
        "last_pw": snap_pw,
        "last_seq": snap_seq,
    })

@app.route("/channels")
def channels():
    """Return channel mapping."""
    return jsonify(CHANNELS)

# --- Camera MJPEG stream (fan-out to multiple clients) ---

camera_proc = None
camera_lock = threading.Lock()
camera_frame = None        # latest JPEG frame bytes
camera_frame_id = 0        # increments each new frame
camera_cond = threading.Condition()

def camera_reader_thread():
    """Single thread reads from rpicam-vid and buffers the latest frame."""
    global camera_proc, camera_frame, camera_frame_id
    while True:
        with camera_lock:
            if camera_proc is None or camera_proc.poll() is not None:
                camera_proc = subprocess.Popen([
                    "rpicam-vid", "-t", "0",
                    "--codec", "mjpeg",
                    "--width", "640", "--height", "480",
                    "--framerate", "10",
                    "--quality", "50",
                    "--vflip", "--hflip",
                    "--inline",
                    "-o", "-",
                ], stdout=subprocess.PIPE, stderr=subprocess.DEVNULL)
            proc = camera_proc
        buf = b""
        while True:
            chunk = proc.stdout.read(4096)
            if not chunk:
                break
            buf += chunk
            while True:
                start = buf.find(b"\xff\xd8")
                if start == -1:
                    buf = b""
                    break
                end = buf.find(b"\xff\xd9", start + 2)
                if end == -1:
                    buf = buf[start:]
                    break
                with camera_cond:
                    camera_frame = buf[start:end + 2]
                    camera_frame_id += 1
                    camera_cond.notify_all()
                buf = buf[end + 2:]
        time.sleep(1)  # restart delay if process dies

def mjpeg_fanout():
    """Generator that yields MJPEG frames from the shared buffer."""
    last_id = 0
    while True:
        with camera_cond:
            camera_cond.wait(timeout=2)
            fid = camera_frame_id
            frame = camera_frame
        if fid != last_id and frame is not None:
            last_id = fid
            yield (b"--frame\r\n"
                   b"Content-Type: image/jpeg\r\n\r\n" + frame + b"\r\n")

@app.route("/camera")
def camera():
    return Response(mjpeg_fanout(),
                    mimetype="multipart/x-mixed-replace; boundary=frame")

if __name__ == "__main__":
    try:
        pca_init(freq=50)
        _servo_seed_last_pw_from_pca()  # L-E: seed last_pw from current registers
    except Exception as e:
        print("PCA9685 init failed; continuing without PCA init: %s" % e, flush=True)
    # No pca_all_off() — groundstation sends neutral positions on connect
    threading.Thread(target=sensor_loop, daemon=True).start()
    threading.Thread(target=simplefoc_jog_watchdog_loop, daemon=True).start()
    threading.Thread(target=simplefoc_status_poll_loop, daemon=True).start()
    threading.Thread(target=camera_reader_thread, daemon=True).start()
    app.run(host="0.0.0.0", port=5000, threaded=True)
