zeulewan/geodude-control/pcb/geodude-carrier/generate_netlist_sklib.py

from collections import defaultdict
from skidl import Pin, Part, Alias, SchLib, SKIDL, TEMPLATE

from skidl.pin import pin_types

SKIDL_lib_version = '0.0.1'

generate_netlist = SchLib(tool=SKIDL).add_parts(*[
        Part(**{ 'name':'Screw_Terminal_01x02', 'dest':TEMPLATE, 'tool':SKIDL, 'aliases':Alias({'Screw_Terminal_01x02'}), 'ref_prefix':'J', 'fplist':[''], 'footprint':'TerminalBlock:TerminalBlock_MaiXu_MX126-5.0-02P_1x02_P5.00mm', 'keywords':'screw terminal', 'description':'Generic screw terminal, single row, 01x02, script generated (kicad-library-utils/schlib/autogen/connector/)', 'datasheet':'', 'pins':[
            Pin(num='1',name='Pin_1',func=pin_types.PASSIVE,unit=1),
            Pin(num='2',name='Pin_2',func=pin_types.PASSIVE,unit=1)], 'unit_defs':[] }),
        Part(**{ 'name':'Fuse', 'dest':TEMPLATE, 'tool':SKIDL, 'aliases':Alias({'Fuse'}), 'ref_prefix':'F', 'fplist':[''], 'footprint':'Fuse:Fuse_Littelfuse_395Series', 'keywords':'fuse', 'description':'Fuse', 'datasheet':'', 'pins':[
            Pin(num='1',func=pin_types.PASSIVE,unit=1),
            Pin(num='2',func=pin_types.PASSIVE,unit=1)], 'unit_defs':[] }),
        Part(**{ 'name':'Conn_01x06_Pin', 'dest':TEMPLATE, 'tool':SKIDL, 'aliases':Alias({'Conn_01x06_Pin'}), 'ref_prefix':'J', 'fplist':[''], 'footprint':'Connector_PinHeader_2.54mm:PinHeader_1x06_P2.54mm_Vertical', 'keywords':'connector', 'description':'Generic connector, single row, 01x06, script generated', 'datasheet':'', 'pins':[
            Pin(num='1',name='Pin_1',func=pin_types.PASSIVE,unit=1),
            Pin(num='2',name='Pin_2',func=pin_types.PASSIVE,unit=1),
            Pin(num='3',name='Pin_3',func=pin_types.PASSIVE,unit=1),
            Pin(num='4',name='Pin_4',func=pin_types.PASSIVE,unit=1),
            Pin(num='5',name='Pin_5',func=pin_types.PASSIVE,unit=1),
            Pin(num='6',name='Pin_6',func=pin_types.PASSIVE,unit=1)], 'unit_defs':[] }),
        Part(**{ 'name':'Conn_01x08_Pin', 'dest':TEMPLATE, 'tool':SKIDL, 'aliases':Alias({'Conn_01x08_Pin'}), 'ref_prefix':'J', 'fplist':[''], 'footprint':'Connector_PinHeader_2.54mm:PinHeader_1x08_P2.54mm_Vertical', 'keywords':'connector', 'description':'Generic connector, single row, 01x08, script generated', 'datasheet':'', 'pins':[
            Pin(num='1',name='Pin_1',func=pin_types.PASSIVE,unit=1),
            Pin(num='2',name='Pin_2',func=pin_types.PASSIVE,unit=1),
            Pin(num='3',name='Pin_3',func=pin_types.PASSIVE,unit=1),
            Pin(num='4',name='Pin_4',func=pin_types.PASSIVE,unit=1),
            Pin(num='5',name='Pin_5',func=pin_types.PASSIVE,unit=1),
            Pin(num='6',name='Pin_6',func=pin_types.PASSIVE,unit=1),
            Pin(num='7',name='Pin_7',func=pin_types.PASSIVE,unit=1),
            Pin(num='8',name='Pin_8',func=pin_types.PASSIVE,unit=1)], 'unit_defs':[] }),
        Part(**{ 'name':'Screw_Terminal_01x04', 'dest':TEMPLATE, 'tool':SKIDL, 'aliases':Alias({'Screw_Terminal_01x04'}), 'ref_prefix':'J', 'fplist':[''], 'footprint':'TerminalBlock:TerminalBlock_MaiXu_MX126-5.0-04P_1x04_P5.00mm', 'keywords':'screw terminal', 'description':'Generic screw terminal, single row, 01x04, script generated (kicad-library-utils/schlib/autogen/connector/)', 'datasheet':'', 'pins':[
            Pin(num='1',name='Pin_1',func=pin_types.PASSIVE,unit=1),
            Pin(num='2',name='Pin_2',func=pin_types.PASSIVE,unit=1),
            Pin(num='3',name='Pin_3',func=pin_types.PASSIVE,unit=1),
            Pin(num='4',name='Pin_4',func=pin_types.PASSIVE,unit=1)], 'unit_defs':[] }),
        Part(**{ 'name':'Conn_01x03_Pin', 'dest':TEMPLATE, 'tool':SKIDL, 'aliases':Alias({'Conn_01x03_Pin'}), 'ref_prefix':'J', 'fplist':[''], 'footprint':'Connector_PinHeader_2.54mm:PinHeader_1x03_P2.54mm_Vertical', 'keywords':'connector', 'description':'Generic connector, single row, 01x03, script generated', 'datasheet':'', 'pins':[
            Pin(num='1',name='Pin_1',func=pin_types.PASSIVE,unit=1),
            Pin(num='2',name='Pin_2',func=pin_types.PASSIVE,unit=1),
            Pin(num='3',name='Pin_3',func=pin_types.PASSIVE,unit=1)], 'unit_defs':[] })])
