zeulewan/geodude-control/(commit log)

2026-03-05 Initial subscale satellite documentation site
    Full zensical site documenting the SOOS-1 subscale test apparatus
    and servicer satellite. Includes BOM tables, power architecture
    diagrams, interconnect tables, and procurement tracking.
2026-03-05 Restructure: topic-based tabs with geodude/gimbal subfolders
    Reorganized from system-split (apparatus/subscale) to topic-based
    tabs (Electrical, Project). GEO-DUDe and Gimbal are now subfolders
    within the Electrical tab. Removed mechanical content. Combined
    BOM into single page under Project.
2026-03-05 Fix slip ring: AC mains passthrough, not DC servo signals
    PSU sits inside rotating GEO-DUDe body. Slip ring (3-wire 15A
    120V rated) passes AC mains through rotation point. Added AC
    wiring path, crimp spade terminal details, connector reference
    table, and safety notes.
2026-03-05 Add real servo/converter specs and power budget analysis
    HOOYIJ 150kg: 10-12.6V, 8A stall. ANNIMOS 80kg: 6-8.4V, 5A stall.
    STS3215: 4-7.4V, 2.5A stall. Buck converters: 20A/300W (15A cont).
    Flagged that 150kg servos can run direct off 12V PSU, freeing up
    two buck converters. Added fuse sizing table.
2026-03-05 Major audit update: all dumb PWM servos, revised power architecture
    - Dropped smart servos (STS3215), Waveshare driver, PCF8575 expander
    - All 14 servos now dumb PWM via PCA9685 I2C driver (add to BOM)
    - Wrist servos TBD (generic ~20kg dumb PWM)
    - Base+shoulder run direct off 12V bus (no buck converter needed)
    - Only 2 of 4 buck converters used (7.4V for elbow, 5V for Pi)
    - ESP32 powered by separate 5V USB adapter
    - Pi+ESP32 communicate via WiFi
    - 6 limit switches direct to Pi GPIO (one per joint)
    - Added Wago power distribution block diagram
    - Added connector reference table
    - Updated all Mermaid diagrams
2026-03-05 Sync BOM with Google Sheet and fix electrical audit inconsistencies
    - BOM page now matches Google Sheet: PCA9685 replaces Waveshare,
    Wishiot RDS3218 replaces RCmall for wrist servos, I2C expander
    marked NOT NEEDED, total updated to $787.57
    - Fix Mermaid diagram: Buck 2 fuse corrected from 3A to 8A
    - Fix dropped components: STS3215 replacement now names RDS3218
    - Fix interconnects: Buck 2 GND return upgraded to 16 AWG
    - Power budget: wrist servo specs filled in, fuse table updated
    with wire gauges and split servo branches
2026-03-06 Complete electrical audit: relay, buck 3, ESP32 pins, design notes
    - Fix 5V servo power gap: add buck conv 3 (5V, after relay) for
    wrist and MG90S servos. Buck 2 now only powers Pi + PCA9685
    (always on, before relay). 3 of 4 buck converters in use.
    - Add 120A irhapsody relay for power-on sequencing with transistor
    driver circuit (2N2222 + flyback diode) documented.
    - Confirm ANNIMOS 150kg shoulder servo: 8.0A stall at 12V (datasheet).
    - Assign ESP32 GPIO pins for 4x TMC2209 STEP/DIR signals.
    - Add relay and GPIO breakout HAT to Google Sheet BOM.
    - Rewrite interconnects DC power section: relay, Cyrico fuse block,
    separate always-on and after-relay paths, GND via fuse block neg bus.
    -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
2026-03-06 Audit TMC2209 stepper drivers and add datasheets reference page
    - TMC2209 audit: document VMOT caps (100uF mandatory), power
    sequencing, UART addressing (MS1/MS2), CLK grounding, current
    setting formula, and critical warnings.
    - Add UART bus wiring to interconnects (shared bus, 1k bridge,
    4 driver addresses, CLK to GND, VIO from ESP32 3.3V).
    - Add datasheets.md with PDF links for all 14 components:
    PCA9685 (NXP), TMC2209 (Analog Devices), ESP32 (Espressif),
    RPi4, MG90S (Tower Pro), servo spec sheets (Amazon-hosted),
    buck converter module datasheet.
    - Full servo quick-reference table with torque, current, speed,
    gear type, IP rating, and weight.
2026-03-06 Add TMC2209 mounting, stepper spec warning, and decoupling caps to BOM
    - Document breadboard mounting for TMC2209 modules in gimbal base
    - Add warning: stepper motor specs unknown, Aidan needs to confirm
    NEMA size and current rating vs TMC2209 1.77A RMS limit
    - Add VMOT decoupling caps (100uF + 100nF per driver) to gimbal
    BOM in Google Sheet - mandatory for driver protection
2026-03-06 Mark stepper motors as confirmed compatible with TMC2209
2026-03-06 Add D2 diagrams, revise power budget and wire sizing
    - 6 hierarchical D2 diagrams (L0 overview, L1/L2 for both systems)
    - Revised wire gauge: 8 AWG -> 10 AWG trunk based on realistic load analysis
    - Revised fuses: 40A -> 25A main DC, 20A -> 15A base/shoulder
    - Fixed relay rating: 120A -> 40A across all docs
    - Added realistic operating current analysis to power-budget.md
    - Updated BOM missing components list with corrected values
2026-03-06 Revise main DC fuse from 25A to 30A to match 10 AWG rating
2026-03-06 Clarify 30A DC fuse as blade fuse + inline holder
2026-03-06 Update CLAUDE.md with electrical design decisions and fuse rationale
2026-03-14 Replace relay with 40A toggle switch, remove transistor driver components
2026-03-14 Replace relay with toggle switch in all electrical diagrams
2026-03-16 Add base station page, MACE reaction wheel, and updated power distribution
    - Add base station electronics page (Raspberry Pi ground control)
    - Add MACE reaction wheel section to GEO-DUDe (motor, ESC, IMU, encoder)
    - Update power distribution: bus boards with slow-blow fuses, 10 AWG trunk, 30A main
    - Replace inline Mermaid diagrams with link to D2-rendered SVGs
    - Update electrical overview with base station card and three-system comparison
2026-03-17 Update electrical docs: wire gauges to 16/18/22 AWG, Jtron toggle switch, remove relay references
2026-03-17 Remove 4x MG90S end-effector servos (design deferred), 14 -> 10 servos
2026-03-17 Restructure for two independent arms, add 10 limit switches
2026-03-17 Simplify limit switch diagram to single box, fix D2 syntax
2026-03-17 Rewrite power diagram: top-down dagre layout, cleaner routing
2026-03-17 Switch power diagram back to horizontal layout, keep dagre
2026-03-17 Place arm fuse boards side by side in power diagram
2026-03-17 Force arm fuse boards left-right horizontal
2026-03-17 Add connector types to fuse board, AS5600 encoder, Pi screw terminal HAT, remove fan
2026-03-17 Fuse board: vertical screw terminal bar (in) and male header bar (out)
2026-03-17 Group ESC/BLDC/encoder in MACE box, add bullet connectors label
2026-03-17 Fix MACE internal arrows, taller connector bars on fuse board, bullet connectors label
2026-03-17 Add ICM20948 IMU to MACE box, clean up stray magnet node
2026-03-17 Make screw terminal and male header bars span full fuse board height
2026-03-17 Uniform fuse widths, GND to fuse board, 3.3V power labels on MACE sensors
2026-03-17 Add Pi to PCA I2C arrow, remove Pi fuse, clean up GND lines
2026-03-17 Compact diagram: smaller fuse widths, shorter bars, MACE direction down
2026-03-17 Restore fuse board size, vertical Pi/PCA/limits stack, remove duplicate limits box, add IMU to MACE
2026-03-17 Grid stacking: controller stack vertical, MACE + fuse board vertical aligned
2026-03-17 Revert to clean layout, add full PCA name, Pi->PCA I2C, remove Pi fuse
2026-03-17 Add VCC/V+ notes to PCA9685 label in power diagram
2026-03-17 Simplify PCA label: VCC 5V, V+ not connected
2026-03-17 Fix PCA power path: goes through Pi not directly from buck, remove PCA from GND label
2026-03-17 Add GND connections to all bucks and MACE ESC
2026-03-17 Revert GND lines, keep label only
2026-03-17 Update GND bus label
2026-03-17 Pin GND bus to bottom-center, reduce whitespace
2026-03-17 Update wire gauges: 12 AWG for trunk and toggle-to-fuse-board, 16 AWG for branches
2026-03-17 Add gauge to MACE ESC line (18 AWG), toggle-to-fuse-board 16 AWG per arm
2026-03-17 Update wiring: 2x16 fork to 10AWG fuse, 2 wagos (12V servos + bucks/MACE)
2026-03-17 Post-toggle: 10 AWG soldered to 2x 16 AWG to wagos
2026-03-17 3 wagos: one arm wago shown as x2, one bucks wago
2026-03-17 Show 10 AWG from toggle to solder split, then 16 AWG to wagos
2026-03-17 Revert solder split node, back to toggle -> wagos directly
2026-03-17 Add GND wiring details to label, no drawn connections
2026-03-17 Note 2x screw terminals for 12V+ and GND on fuse board
2026-03-17 Note 11x screw terminals per fuse board with breakdown
2026-03-17 Male headers: 5x 3-pin
2026-03-17 Pi path: direct from PSU, no fuse, separate from servo path
2026-03-17 Switch to TALA layout engine (watermark until licensed)
2026-03-17 Switch back to ELK layout, no watermark
2026-03-18 Separate MACE onto own fuse direct from PSU, off the toggle path
2026-03-18 Servo path fuse: 30A -> 40A
2026-03-18 MACE direct from PSU, no fuse
2026-03-18 MACE: 12 AWG from PSU to ESC via XT60
2026-03-18 Add brownout ride-through cap between buck 2 and Pi
2026-03-18 Cap moved into Pi label, ESC PWM+GND only (no 5V)
2026-03-18 Full ESC name: Drfeify 40A ESC
2026-03-18 Add V+ and GND bus bars (250A 5/16 stud), all paths from bus bar
2026-03-18 Switch to TALA layout engine (licensed)
2026-03-18 TALA for all diagrams, update MACE motor to 40A, clean up labels
2026-03-18 Pin PSU to center-left for left-to-right flow with TALA
2026-03-18 TALA seed 11: MACE near arm fuse board, left-to-right flow
2026-03-20 Add solder split node between toggle and wagos
2026-03-20 Switch back to ELK layout, remove TALA near:arm, add solder split node
2026-03-20 Note 2x wire split on arm Wago label
2026-03-20 Arm wago to fuse board: 2x 16 AWG, note 10A screw terminal reason
2026-03-20 Combine stepper drivers and motors into one block, simplify gimbal diagram
2026-03-20 Split into 4x TMC2209 drivers + 4x NEMA 17 motors as two blocks
2026-03-20 Remove gimbal 12A fuse (TMC2209 + PSU protection sufficient)
2026-03-20 Add gimbal perfboard: ESP32, TMC2209s, caps, resistor, screw terminals, JST sockets
2026-03-20 Fix gimbal: VMOT power goes direct from bus bar to drivers, not through perfboard
2026-03-20 Remove fuse note from diagram, add AC current calc to gimbal docs page
2026-03-20 Add 24V screw terminals to perfboard, barrel jack from separate wall outlet
2026-03-20 Remove ring terminals note from wire label
2026-03-20 Add 24V to bus bar -> screw terminal label
2026-03-20 Fix cap routing: parallel across VMOT/GND, not in series
2026-03-20 Gimbal perfboard: vertical screw terminal bar (in) and JST bar (out), matching geodude style
2026-03-20 Move WiFi note into ESP32 box, remove separate WiFi node
2026-03-20 Update L0 test setup: bus bars, perfboard, 10 servos, MACE direct, limits, barrel jack
2026-03-20 Add wire gauges to all gimbal connections
2026-03-20 Separate screw terminals and barrel jack into distinct boxes on gimbal perfboard
2026-03-20 Move screw terminals and barrel jack to board edge containers
2026-03-24 Gitignore servo position and neutral JSON files
2026-03-24 Add controller mode for manual arm control
2026-03-24 Honor GUI servo speed in controller mode
2026-03-24 Fix DualShock axis and deadman mapping
    [wheel_control.py]
2026-03-24 Add per-arm controller selection
2026-03-24 Fix controller state initialization
    [wheel_control.py]
2026-03-24 Expand ML vision panel to three model slots
2026-03-24 Add frontend arm workspace visualization
2026-03-24 Refine servo workspace layout and keep-out view
2026-03-24 Add draggable arm view and compact control cards
2026-03-24 Compact dashboard layout and reverse arm drag
2026-03-24 Update arm visualization joint axes
2026-03-24 Add arm visualization live and test modes
2026-03-24 Fix base joint axis in arm visualization
2026-03-24 Use measured satellite size and arm mounts
2026-03-24 Compact sensors card and tighten top grid
2026-03-24 Add draggable dashboard tiles and arm dimensions
2026-03-24 Add zoom controls to arm visualization
2026-03-24 Show IK target and solved pose in dev arm view
2026-03-24 Fix dev IK geometry and add armviz hot edits
    [wheel_control.py]
2026-03-24 Use dev IK angles for live arm visualization
2026-03-24 Use IK calibration for test arm preview
2026-03-24 Center dev IK around straight-arm mid PWM
2026-03-24 Route IMU and encoder reads through Pico serial instead of Pi I2C
    sensor_server.py: replace direct I2C reads (0x69/0x36) with Pico serial
    queries using E and G commands. Add simplefoc_query() with pico_lock.
    Update /simplefoc/status to include sensor data fields.
    wheel_control.py: add encoder_angle and rpm to /api/mace/status response.
    Frontend: add Encoder Angle row to MACE Status card; macePoll() now
    populates encoder_angle and uses real rpm from sensor data instead of
    estimating from velocity.
    [wheel_control.py]
2026-03-24 Add camera stream toggle to dashboard
2026-03-24 cd /home/mizi/geodude-dev/groundstationAdd camera stream toggle to dashboard fuser -k 8081/tcp || true (env WHEEL_CONTROL_PORT=8081 WHEEL_CONTROL_DRY_RUN=1 WHEEL_CONTROL_RESTORE_ON_START=0 nohup pyth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
2026-03-24 Scope camera off overlay to camera tile
2026-03-24 Add full Pico telemetry to MACE status UI
2026-03-24 Bias dev IK toward stiffer wrist-assisted poses
    [wheel_control.py]
2026-03-24 Add solved-pose move and IK stiffness optimizer
    [wheel_control.py]
2026-03-24 Reject flipped elbow IK postures in dev solver
    [wheel_control.py]
2026-03-24 Update dev mission simulation flow
2026-03-24 Refine dev mission flow layout
2026-03-24 Tighten dev mission flow grid
2026-03-24 Fit dev mission flow on one line
2026-03-24 Keep dev mission camera and stack adjacent
2026-03-24 Add EN active LOW and MS1/MS2 address table to TMC2209 driver label
2026-03-24 Move TMC2209 address table to separate box below drivers
2026-03-24 Single fuse board (10 servos), PCA on board, single Wago, no solder split
2026-03-24 Simplify fuse board: 3 grouped fuse blocks (4x8A, 2x5A, 4x3A) instead of 10 individual
2026-03-24 Fix screw terminal count: 2x 7.4V and 2x 5V inputs
2026-03-24 Move PCA9685 outside fuse board block
2026-03-24 PCA PWM to male headers (11x: 10 servos + 1 MACE ESC)
2026-03-24 PCA as bottom bar on fuse board, PWM direct to headers, power-only screw terminals
2026-03-24 Widen fuse blocks to fit text
2026-03-25 Add dev approach arm positioning substeps
2026-03-25 Add dev AOCS attach mission substeps
2026-03-25 Add mission arm view to dev simulation tab
2026-03-25 Refine dev mission arm view
2026-03-25 Enable mission arm view mouse controls
2026-03-25 Remove mission camera caption
2026-03-25 Color dev mission simulation buttons
2026-03-25 Reduce dev competition flow to key steps
2026-03-25 Update SimpleFOC control flow and groundstation UI
2026-03-25 Wire MACE controls to Nucleo: enable/disable/velocity/calibrate/tune commands
2026-03-25 MACE: RPM input, enable/disable/stop/calibrate buttons, voltage limit
2026-03-27 Fix All Neutral button: send PWM command to hardware
    chGoNeutral() was only updating the slider UI without calling
    chSendPwm(), so the button had no effect on actual servo positions.
2026-03-27 Nucleo firmware rewrite, sensor server Nucleo protocol, competition gating updates
    - Firmware: 11 pole pairs, PPR=800, current sense, torque mode, profile runner
    - Sensor server: JSON status protocol, live control state, profile log parsing
    - Frontend: Snoopy confidence threshold, lock frame gating, class whitelist
    - Dashboard: MACE control panel updates
    - Mission: minor UI additions
2026-03-27 Update PCA channel mapping to match physical hardware
    Actual servo placement differs from PCB silkscreen labels. Observed by
    moving each PCA channel and identifying which servo physically moved:
    ch0=B1, ch1=S1, ch2=B2, ch3=S2, ch4=E1, ch5=E2, ch6=W1A, ch7=W1B,
    ch8=W2A, ch9=W2B.
    Also hardcodes servo neutrals in app.js (removes dependency on
    servo_neutral.json fetch) and removes the direct chSendPwm call from
    chGoNeutral so the servo ramp loop handles smooth neutral transitions.
2026-03-27 Nuclear frontend cleanup: remove mission, competition, MACE, attitude, IK; flatten structure
    Removed features (code preserved in git history):
    - Mission Simulation tab and state machine
    - MACE Competition tab (740 lines backend + tab UI)
    - MACE Reaction Wheel dashboard card (body-rate PID)
    - Angle Control dashboard card (angle PID)
    - Inverse Kinematics card and solver UI (minimal ikStatus stub kept for ArmViz)
    - Attitude controller proxy routes and JS
    - MACE SimpleFOC controls and run-log tester
    - ESC calibration wizard
    Structural cleanup:
    - Flattened groundstation/frontend/ and groundstation/backend/ back into groundstation/
    - Inlined templates/partials/dashboard.html into index.html
    - Del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
2026-03-27 Gimbal firmware: OTA resilience, POST /reboot, driverFound cache, UART race guards
    Firmware (firmware/esp32/gimbal_controller.ino):
    - Cache per-driver found state (driverFound[4]); handleStatus returns the cached
    value during stepping so the dashboard stops flashing NOT FOUND while a motor
    is actually moving.
    - handleMotorIhold now applies the change to the driver immediately when the
    motor is idle-but-enabled. Previously the value was only stored in RAM and
    took effect on the next stepping cycles end, so users could not set standstill
    current on an already-stopped motor.
    - sendBusyIfStepping() guards handleMotorCurrent/Enable/Disable with a 409 Busy
    response so concurrent HTTP c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
    [gimbal_controller.ino]
2026-03-27 Gimbal: fix ihold overwriting irun, remove dead updateArmUI call
    handleMotorIhold was calling rms_current(ma, 1.0f) which sets both IRUN and
    IHOLD to the same CS value. Setting ihold on an idle driver was downgrading
    its run current too, which is why Roll showed ~400mA actual instead of the
    1200mA the user had configured.
    Now use rms_current(run_ma, hold_ratio) so IRUN stays pinned to the user-set
    run current and only IHOLD changes. Verified on the Roll axis:
    run_ma=1200, ihold_ma=420 -> irun=20 (~1160mA), ihold=7 (~400mA)
    Frontend: removed an orphaned call to updateArmUI() (deleted in the earlier
    nuclear cleanup). That ReferenceError was aborting the sensors poll before it
    could flip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
    [gimbal_controller.ino]
2026-03-27 Servo safety: server-side ramp, max-delta clamp, seq numbers, heartbeat watchdog
    Servos are safety-critical. Previously the ramp lived in the browser, which
    means a dropped command between the browser and the groundstation (or between
    the groundstation and the GEO-DUDe Pi) would silently skip a tick; the next
    command that did land would cause the servo to jump to the larger delta.
    Defense in depth, ranked outermost to innermost:
    1. Browser: publishes slider targets only. No more client-side ramp loop.
    Moving a slider posts the target to /api/pwm and returns; the server
    owns the trajectory.
    2. Groundstation (wheel_control.py): authoritative ramp thread at 30 Hz.
    Steps actual towar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
    [sensor_server.py, wheel_control.py]
2026-03-27 Servo safety v2: fix all CRITICAL and top HIGH audit findings
    After a paranoid audit, patched the five CRITICAL findings and the top HIGH
    findings. Each of these could have caused an unexpected servo jump.
    CRITICAL fixes:
    - C1: Removed restore_positions_loop. It bypassed both the server-side ramp
    and GEO-DUDes 50us clamp (on a fresh GEO-DUDe boot last_pw is None so
    the first raw write was unbounded). _servo_init_state already seeds
    target == actual from servo_positions.json; no motion until an
    explicit command.
    - C2: _servo_send_to_geodude now catches 409 stale-seq responses and jumps
    _servo_seq past the servers last_seq so the ramp auto-resyncs after
    a g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
    [sensor_server.py, wheel_control.py]
2026-03-27 Servo safety v3: remaining audit findings (H2, M4, L3, L5, L6)
    H2 heartbeat freeze recovery:
    servoSyncPoll now watches state.heartbeat_age_s. On recovery edge
    (frozen -> alive) it force-updates every slider to the current server
    target even if the user is mid-drag, so a stuck-mid-drag slider cannot
    jump the arm back to a pre-freeze value on release. Also tints the
    status dot warn during freeze and alarm when ramp_age_s > 1s.
    M4 PCA9685 readback:
    pca_set_pulse_us writes, then reads the same 4 bytes back and compares.
    Mismatches and write errors increment counters exposed on a new GET
    /pwm_health route. Closes the silent-write-loss class of failure.
    L3 chGoNeutral no longer r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
    [sensor_server.py, wheel_control.py]
2026-03-27 Servo safety v4: second audit findings (C-A, C-B, H-A..E, L-B, L-D, L-E, M-C..F)
    Second paranoid audit found that v3 still left a few holes. These fixes
    close them all.
    - C-A: Groundstation no longer blindly trusts accepted_pw returned from
    GEO-DUDe. Clamp to [0..2500] and to the per-channel envelope before
    assigning it to _servo_actual_pw. If the remote somehow returns a value
    larger than what we asked for, log and use our requested value.
    - C-B: _servo_heartbeat now writes _servo_last_heartbeat under
    _servo_state_lock so the ramp thread never tear-reads it.
    HIGH fixes:
    - H-A: Added POST /api/servo_limits/reload so operators can tighten the
    servo_limits.json enve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
    [sensor_server.py, wheel_control.py]
2026-03-27 Servo safety v5: third audit findings (C1 seq race, H1 echo validation, H2 disarm, M2/M3, L2)
    Third audit found a CRITICAL seq race and two HIGH issues.
    CRITICAL:
    - C1: _servo_seq[name] was read and written by _servo_send_to_geodude
    without a lock. The ramp thread and send_all_off can call it
    concurrently on the same channel; they would compute identical seqs,
    submit duplicates, and the loser would get 409-locked out, potentially
    forever if the resync path also races. Fixed with per-channel
    _servo_seq_locks[name].
    HIGH:
    - H1: The groundstation used to clamp GEO-DUDes echoed accepted_pw into
    the envelope and trust that value. This silently made the groundstation
    believe the se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
    [wheel_control.py]
2026-03-27 Servo safety v6: fourth audit findings (H1, M1, M2, L1, N1)
    Fourth audit verdict was safe for bench use with caveats. These are
    the caveats.
    - H1: send_all_off used to set _servo_disarmed=True even when some
    channels failed to stop, leaving an inconsistent model (groundstation
    believed everything was at 0 but a channel could still be energized).
    Now returns (ok, failures). /api/all_off returns HTTP 503 with the
    list of failing channels on partial failure and does NOT raise the
    disarm flag. Operator must resolve the failure (power-cycle PCA rail)
    instead of getting a false all-clear.
    MEDIUM:
    - M1: /api/pwm used to call _servo_set_target (lock + release) then
    _servo_heart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
    [wheel_control.py]
2026-03-27 Remove dead _servo_set_target (inlined into /api/pwm in v6)
    Fifth audit flagged this as dead code (M-2). The function was inlined
    into /api/pwm in v6 and had no other callers. Left around it was a
    drift hazard: a future contributor could re-add a caller that skips
    the disarmed check inside the state lock.
    [wheel_control.py]
2026-03-27 Add pwm_seed to prevent 50us staircase on unpowered channels
    GEO-DUDe:
    - New POST /pwm_seed writes a requested pw directly to the PCA and sets
    _servo_last_pw in one step. Only accepted when the channel is currently
    unseeded (last_pw is None or 0); rejected with 409 if a live signal is
    present. Cannot be used to bypass the 50us delta clamp on a moving servo.
    Groundstation:
    - _servo_bootstrap_seed runs once on startup after _servo_init_state.
    Queries GEO-DUDes /pwm_health; for any channel at 0/None, POSTs
    /pwm_seed with the saved neutral so the servo snaps cleanly to neutral
    in one PCA write instead of staircasing from 0 via the delta clamp.
    - _servo_snapshot now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
    [sensor_server.py, wheel_control.py]
2026-03-29 Initial commit: groundstation web UI and GEO-DUDe sensor/motor server
    wheel_control.py - Flask web UI on groundstation (port 8080)
    - MACE reaction wheel control with server-side ramp, watchdog
    - PCA9685 servo channel sliders (500-2500us)
    - Live IMU/encoder readout from GEO-DUDe
    sensor_server.py - Flask API on GEO-DUDe (port 5000)
    - PCA9685 I2C PWM driver for all channels
    - ICM20948 IMU + AS5600 encoder polling
    - Per-channel PWM control endpoints
    pca9685_test.py - PCA9685 connection test and channel mapping
2026-03-30 Add live camera preview, servo slider improvements
    - MJPEG camera stream from RPi Camera Module 3 (640x480 @ 15fps)
    - Proxied through groundstation to web UI
    - Servo sliders: thumb-drag only (no track click-jump)
    - Center button ramps slowly instead of jumping
    - Servo channels always active at 1500us on load
    - ON/OFF toggle replaced with always-on (servos need continuous signal)
    - All servo ranges extended to 500-2500us
    - MACE power slider starts at 0%
    - Release hold = instant idle (coast), ramp only on spin-up
    [sensor_server.py, wheel_control.py]
2026-03-30 Camera: 720p, 180 degree flip
    [sensor_server.py]
2026-03-30 MACE: min power 10%, ramp starts from 10% floor
2026-03-30 Camera: 1280x960 4:3 uncropped
2026-03-30 Camera: back to 1280x720 16:9 (full sensor width)
2026-03-30 Fix ramp_loop: send motor command when target reached, not just during ramp
    Bug: when throttle floor (10%) == target, ramp_loop skipped sending
    entirely because target==current triggered continue. Motor never got
    the command.
    [wheel_control.py]
2026-03-30 Increase sensor polling to 30Hz through full chain
    GEO-DUDe sensor loop: 20Hz -> 30Hz
    Groundstation sensor poll: 10Hz -> 30Hz
    Browser poll: 10Hz -> 30Hz
2026-03-30 Fix encoder needle 0/360 wraparound jump, match transition to 30Hz
    [wheel_control.py]
2026-03-30 Add brake button and RPM display
    Brake: sends 1000us (idle) but stays armed - ESC applies brake if enabled
    RPM: calculated from encoder angle deltas, 15-sample rolling average
2026-03-30 Compute RPM server-side at 100Hz, 50-sample rolling average
    Encoder sampled at 100Hz on GEO-DUDe instead of 30Hz in browser.
    RPM averaged over 50 samples (0.5s window) for smooth reading.
    Fixes jumpy RPM and aliasing above 900 RPM.
    [sensor_server.py, wheel_control.py]
2026-03-30 Fix NaN RPM: forward rpm field from GEO-DUDe to browser
    [wheel_control.py]
2026-03-30 Add closed-loop attitude controller with PID
    New: attitude_controller.py (GEO-DUDe, port 5001)
    - 100Hz PID control loop on gz gyro axis
    - Gyro bias calibration on enable (2s stationary)
    - Body angle from gyro integration (unbounded)
    - Rate-limited output (40.5%/s max)
    - Deadband-skip mapping (10% motor minimum)
    - Anti-windup integral clamping
    - Wheel saturation detection from encoder RPM
    - 5s watchdog auto-disable
    - Flask API: enable, disable, setpoint, nudge, zero, gains, calibrate, stop
    Modified: wheel_control.py
    - Attitude Control UI card with angle dial, nudge buttons, PID gain sliders
    - Proxy endpoints to attitude controller
    - Mutual exclusion with manual MACE control
    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
    [sensor_server.py, wheel_control.py]
2026-03-30 Fix arm button flicker: skip DOM updates when state unchanged
    [wheel_control.py]
2026-03-30 Max wheel RPM limit: 600, force coast when saturated
2026-03-30 Use mDNS hostnames instead of hardcoded IPs
    geodude.local resolves via avahi regardless of network topology
    [wheel_control.py]
2026-03-30 Add system stats (CPU, temp, load) for both Pis
    Reduce bandwidth for slow WiFi link (~3 Mbps):
    - Camera: 640x480 @ 10fps, quality 50 (was 1280x720 @ 15fps)
    - Sensor poll: 10Hz (was 30Hz)
    - System stats poll: 0.5Hz
2026-03-30 Hardcode GEO-DUDe IP, skip DNS for offline network
    [wheel_control.py]
2026-03-30 Revert sensor loop to 30Hz — 100Hz caused I2C lock contention with motor writes
    [sensor_server.py]
2026-03-30 Fix: attitude controller was sending 1000us when disabled, auto-arming ESC
    Control loop was flooding ESC with idle signal every 10ms even when
    disabled. Now does nothing when disabled — leaves MACE channel alone
    for manual control.
2026-03-30 Fix saturation oscillation with hysteresis, UI cleanup
    - RPM saturation: coast when >=600 RPM, resume at 70% (420 RPM)
    - Removed emergency stop (same as disarm)
    - Added RPM and saturation status to system card
    - Added note: brake = coast (ESC brake mode not enabled)
    [wheel_control.py]
2026-03-30 Reduce RPM averaging window from 50 to 10 samples for faster response
2026-03-30 Update gimbal ESP32 docs: pin assignments, UART wiring, network config
    - Corrected STEP/DIR pin assignments to match firmware (GPIO 32/33, 25/26, 23/22, 19/18)
    - Added UART pin assignment: GPIO 16 (RX) / GPIO 17 (TX) with 1K resistor
    - Documented BTT TMC2209 V1.3 single-wire UART wiring (factory default RX pin only)
    - Added ESP32 firmware details: web UI, OTA, WiFi, driver scanning, motor control
    - Added note that 24V on VM is required for UART communication
    - Updated base station with hostname, WiFi hotspot config, network architecture
    - Added NAT/routing setup for laptop to reach ESP32 through Pi
    - Updated interconnects table to match all pin changes
2026-03-30 Update basestation and GEO-DUDe docs with current system state
    Basestation:
    - WiFi hotspot SSID/password, bandwidth measurement
    - Full software docs: web UI panels, API endpoints, networking notes
    - Corrected polling rates and RPM averaging
    - Added hostname, OS, IP, SSH access, services table
    - PCA9685 channel map, corrected IMU address (0x69)
    - MACE control details: ESC specs, deadband, RPM limiting with hysteresis
    - Attitude controller docs
    - Camera specs
    - Sensor loop rate corrected to 30Hz
    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
2026-03-30 GEO-DUDe: merged two per-arm fuse boards into one
2026-03-30 Add GEO-DUDe carrier PCB design doc
2026-03-30 Initial KiCad project for GEO-DUDe carrier PCB
    Project file with net classes for power traces (8A/5A/3A).
    Schematic WIP - needs rail corrections.
    [geodude-carrier.kicad_sch]
2026-03-30 Fix carrier PCB schematic: 5 power rails, PCA9685 on 3.3V
    - +12V (servo power, ESC, fan)
    - +7V4 (elbow servo power)
    - +5V_SERVO (wrist servo power, from buck 3)
    - +5V_LOGIC (from Pi 5V, general purpose)
    - +3V3 (from Pi 3.3V, PCA9685 VCC, I2C bus)
    [geodude-carrier.kicad_sch]
2026-03-30 Fix schematic: add missing rotation angles to all symbol placements
    [geodude-carrier.kicad_sch]
2026-03-30 Add SKiDL netlist generator for carrier PCB
2026-03-30 Fix SKiDL symbol names for KiCad 10 (Conn_01xNN_Pin)
    [generate_netlist.py]
2026-03-30 Add PCB layout generator script
2026-03-30 Fix PCB generator: correct footprint names, remove broken zone API
2026-03-30 Fix PCB layout: larger board (150x120), proper fuse spacing
2026-03-30 WIP: paralleled 12V/GND terminals, pending fuse holder measurements
    Power input: 4x 12V, 2x GND (paralleled for current), plus 7V4, 5V servo, 5V logic, 3.3V
    Fuse holder footprint needs BLX-A pin spacing measurement
    Screw terminals: 2-pin and 3-pin, 5mm pitch (Tnisesm TN-T03B)
2026-03-30 Custom BLX-A fuse footprint, updated PCB layout with paralleled 12V/GND
2026-03-30 Fix footprint names in netlist, horizontal power terminal layout
    [generate_netlist.py]
2026-03-30 Full programmatic PCB: nets created and assigned to pads, no GUI import needed
2026-03-30 Add programmatic trace routing with current-aware widths
    Power traces: 3mm (8A), 2mm (5A), 1.2mm (3A)
    Signal traces: 0.4mm (PWM, I2C)
    GND routed on back copper layer
    All power, signal, and I2C connections routed
2026-03-30 Disable manual routing (traces cross), prepare for Freerouting
2026-03-30 Fix component overlap: increase spacing for terminals, PCA, I2C
2026-03-30 Fully routed PCB — Freerouting autorouter, 0 DRC violations
    280 traces, 39 components, 35 nets
    Freerouting completed in 3 passes (~1.5s)
    DRC: 0 violations, 0 unconnected items
    Headless pipeline: pcbnew API → DSN export → Freerouting → SES import
    [geodude-carrier.dsn, geodude-carrier.kicad_pcb]
2026-03-30 Redesign layout (power top, fuses middle, headers bottom) + routing pipeline
    - Full headless pipeline: generate → DSN export → patch widths → Freerouting → import SES → DRC → SVG
    - Net class trace widths: 3mm (8A/12V/GND), 2mm (5A/7.4V), 1.5mm (3A/5V), 0.4mm (signal)
    - Component layout: power inputs top, fuses+PCA center, servo/ESC/I2C bottom
2026-03-30 Fix DSN units (um not mm), ESC header to 2-pin (PWM+GND only)
2026-03-30 Redesign: 1x19 PCA socket on edge, clean unrouted layout for manual adjustment
    PCA9685 socket: single 1x19 female header (pins 5/10/15 NC for cap gaps)
    Control pins (VCC/GND/SDA/SCL/OE) wired via Dupont, not on PCB
    Layout: power top, fuses middle, PCA right edge, servos+ESC+I2C bottom
2026-03-30 Manual placement adjustments from KiCad
    [geodude-carrier.kicad_pcb]
2026-03-30 Add logic bus section, separate GND/GND_LOGIC, custom BLX-A fuse, ESC 3-pin
    Bus section (left edge): SDA, SCL, 3.3V, 5V logic, GND_LOGIC
    - 4x single pin headers + 2x screw terminals per bus
    Power GND: 4x screw terminals (separate from logic GND)
    Both GNDs connect at bus bar, not on PCB
    ESC: 3-pin (PWM, NC, GND)
    Fuse holders: custom BLX-A footprint (28x10mm, ~24mm pin spacing)
2026-03-30 Replace single pin headers with 1x4 headers for bus section
2026-03-30 Fix overlaps: wider board, spread fuses/servos right, clear bus section
2026-03-30 Push fuses further right to clear bus overlap
2026-03-30 Rotate servo/ESC/fan headers 90 degrees
2026-03-30 All power screw terminals in one line at top edge
2026-03-30 Clean silkscreen labels: B1/S1/E1/W1A etc, readable power names
2026-03-30 Arm1 left, arm2 right layout - fuses and servos aligned
2026-03-30 Fix fuse overlap with bus section
2026-03-30 Show value on silkscreen, hide reference designators
2026-03-30 Layout: logic bus left edge, servo headers right edge, PCA top edge
2026-03-30 Layout: power right edge, logic left edge, PCA top, servos bottom
2026-03-30 Fix: PCA horizontal (90deg), push fuses right to clear bus
2026-03-30 BLX-A fuse footprint: measured 22.63mm pitch, 1.5mm drill
2026-03-30 Logic bus: screw terminals in column left, headers column right
2026-03-30 Logic bus: all screw terminals in single vertical column
2026-03-30 Centre PCA socket on top edge
2026-03-30 PCA pin 1 on right (270 deg rotation)
2026-03-30 Centre PCA socket properly (account for pin 1 origin offset)
2026-03-30 ESC/Fan row above servos, silkscreen below servo pins horizontal, swap SDA/SCL order
2026-03-30 Remove logic terminals from right power column (already on left bus)
2026-03-30 Silkscreen: servo labels closer+horizontal, all terminals rotated to match
2026-03-30 Centre servo row, centre ESC/Fan, bring fuses closer
2026-03-30 Fix servo/ESC/fan silkscreen alignment, consistent offset
2026-03-30 Manual silkscreen adjustments
    [geodude-carrier.kicad_pcb]
2026-03-30 Rotate screw terminal silk 90°, label fuses with servo names
    [geodude-carrier.kicad_pcb]
2026-03-30 Remove 4 separate GND terminals
    [geodude-carrier.kicad_pcb]
2026-03-30 Sync generate_pcb.py: remove GND terminals
2026-03-30 Align bus headers vertically with their screw terminal pairs
    [geodude-carrier.kicad_pcb]
2026-03-30 12V/GND dedicated terminals (both pins same net), relabel J3/J4 as GND
    [geodude-carrier.kicad_pcb]
2026-03-30 Rewrite carrier PCB docs to match current design
2026-03-30 Manual layout adjustments
    [geodude-carrier.kicad_pcb]
2026-03-30 Fix SV10 position, snap all components to grid
    [geodude-carrier.kicad_pcb]
2026-03-30 Swap arm 1 and arm 2 servo header sides
    [geodude-carrier.kicad_pcb]
2026-03-30 Routed 276 traces, 1 unconnected (SV3-PCA Ch2 needs manual route)
    [geodude-carrier.kicad_pcb]
2026-03-30 Routed 276 traces (2-layer), fix J1/J2 both pins +12V, J3/J4 both pins GND
    [geodude-carrier.kicad_pcb]
2026-03-30 Clean re-route: 254 tracks, no shorts, J1/J2 all +12V, silkscreen preserved
    [geodude-carrier.kicad_pcb]
2026-03-30 Fully routed: 309 tracks, 0 unconnected, 0 shorts, silkscreen from manual save
    [geodude-carrier.kicad_pcb]
2026-03-30 Re-routed with spacing between terminal groups, 2 unconnected remaining
    [geodude-carrier.kicad_pcb]
2026-03-30 Aligned bus headers centred between screws, fully routed 284 tracks, 0 unconnected
    [geodude-carrier.kicad_pcb]
2026-03-30 Updated board bounds
    [geodude-carrier.kicad_pcb]
2026-03-30 Re-routed with default clearance, 2 unconnected remaining, via sizing needs work
    [geodude-carrier.kicad_pcb]
2026-03-30 Bigger vias, parallel power vias added, JLCPCB free tier via size
    [geodude-carrier.kicad_pcb]
2026-03-30 Clean route with 0.8mm power vias, 2 unconnected remaining
    [geodude-carrier.kicad_pcb]
2026-03-30 Fully routed: fuses swapped to match servo sides, 0 unconnected, JLCPCB vias
    [geodude-carrier.kicad_pcb]
2026-03-30 Production ready: copper pours (GND B.Cu, 12V F.Cu), Gerbers exported, 0 DRC errors
    - GND copper pour on back layer (full board)
    - +12V copper pour on front layer (right half, power area)
    - Gerbers: F.Cu, B.Cu, F.Silk, B.Silk, F.Mask, B.Mask, Edge.Cuts, drill
    - DRC: 0 violations, 0 unconnected (3 silk warnings)
    - Vias: 0.3mm/0.4mm (JLCPCB free tier)
    - Trace widths verified against IPC-2221 at 2oz copper
    [geodude-carrier-B_Cu.gbl, geodude-carrier-B_Mask.gbs, geodude-carrier-B_Silkscreen.gbo, geodude-carrier-Edge_Cuts.gm1, geodude-carrier-F_Cu.gtl, geodude-carrier-F_Mask.gts, geodude-carrier-F_Silkscreen.gto, geodude-carrier-job.gbrjob]
2026-03-30 Manual placement adjustments
    [geodude-carrier.kicad_pcb]
2026-03-30 Re-routed with updated placement, copper pours, Gerbers exported
    233 tracks, 0 unconnected, 3 silk warnings, 1 thermal relief warning
    GND pour B.Cu full board, +12V pour F.Cu right half
    JLCPCB vias 0.3/0.4mm, Gerbers ready
    [geodude-carrier-B_Cu.gbl, geodude-carrier-B_Mask.gbs, geodude-carrier-B_Silkscreen.gbo, geodude-carrier-Edge_Cuts.gm1, geodude-carrier-F_Cu.gtl, geodude-carrier-F_Mask.gts, geodude-carrier-F_Silkscreen.gto, geodude-carrier-job.gbrjob]
2026-03-30 Layout update
    [geodude-carrier.kicad_pcb]
2026-03-30 230 tracks, 1 unconnected (fan PWM - manual route needed), Gerbers updated
    [geodude-carrier-B_Cu.gbl, geodude-carrier-B_Mask.gbs, geodude-carrier-B_Silkscreen.gbo, geodude-carrier-Edge_Cuts.gm1, geodude-carrier-F_Cu.gtl, geodude-carrier-F_Mask.gts, geodude-carrier-F_Silkscreen.gto, geodude-carrier-job.gbrjob]
2026-03-30 Fuses tightened (15mm vert, 36.5mm horiz), fully routed 264 tracks, 0 unconnected, Gerbers ready
    [geodude-carrier-B_Cu.gbl, geodude-carrier-B_Mask.gbs, geodude-carrier-B_Silkscreen.gbo, geodude-carrier-Edge_Cuts.gm1, geodude-carrier-F_Cu.gtl, geodude-carrier-F_Mask.gts, geodude-carrier-F_Silkscreen.gto, geodude-carrier-job.gbrjob]
2026-03-30 Servo headers in two rows (arm1 top, arm2 bottom), ESC/Fan on arm2 row, 0 unconnected, Gerbers ready
    [geodude-carrier-B_Cu.gbl, geodude-carrier-B_Mask.gbs, geodude-carrier-B_Silkscreen.gbo, geodude-carrier-Edge_Cuts.gm1, geodude-carrier-F_Cu.gtl, geodude-carrier-F_Mask.gts, geodude-carrier-F_Silkscreen.gto, geodude-carrier-job.gbrjob]
2026-03-30 Manual placement cleanup
    [geodude-carrier.kicad_pcb]
2026-03-30 Snap screw terminals in columns on each side
    [geodude-carrier.kicad_pcb]
2026-03-30 Routed 322 tracks, 0 unconnected, copper pours, Gerbers ready
    [geodude-carrier-B_Cu.gbl, geodude-carrier-B_Mask.gbs, geodude-carrier-B_Silkscreen.gbo, geodude-carrier-Edge_Cuts.gm1, geodude-carrier-F_Cu.gtl, geodude-carrier-F_Mask.gts, geodude-carrier-F_Silkscreen.gto, geodude-carrier-job.gbrjob]
2026-03-30 Fuse pads 22.2mm, mounting holes, left terminals aligned, needs re-route
    [geodude-carrier-B_Cu.gbl, geodude-carrier-B_Mask.gbs, geodude-carrier-B_Silkscreen.gbo, geodude-carrier-Edge_Cuts.gm1, geodude-carrier-F_Cu.gtl, geodude-carrier-F_Mask.gts, geodude-carrier-F_Silkscreen.gto, geodude-carrier-job.gbrjob]
2026-03-30 Aligned left terminals and servo rows, unrouted - needs placement review
    [geodude-carrier.kicad_pcb]
2026-03-30 Remove duplicate left screw terminals - 1x per bus now
    [geodude-carrier.kicad_pcb]
2026-03-30 Left bus: screw+header pairs aligned, 12mm spacing
    [geodude-carrier.kicad_pcb]
2026-03-30 Spacing update
    [geodude-carrier.kicad_pcb]
2026-03-30 Mounting holes 50mm horizontal spacing, centred
    [geodude-carrier.kicad_pcb]
2026-03-30 Placement update
    [geodude-carrier.kicad_pcb]
2026-03-30 Routed, bigger silk, ESC/Fan fixed, Gerbers - 5 unconnected need manual route
    [geodude-carrier-B_Cu.gbl, geodude-carrier-B_Mask.gbs, geodude-carrier-B_Silkscreen.gbo, geodude-carrier-Edge_Cuts.gm1, geodude-carrier-F_Cu.gtl, geodude-carrier-F_Mask.gts, geodude-carrier-F_Silkscreen.gto, geodude-carrier-job.gbrjob]
2026-03-30 Spread out layout, fan above ESC, 244 tracks, 1 unconnected PWM, Gerbers ready
    [geodude-carrier-B_Cu.gbl, geodude-carrier-B_Mask.gbs, geodude-carrier-B_Silkscreen.gbo, geodude-carrier-Edge_Cuts.gm1, geodude-carrier-F_Cu.gtl, geodude-carrier-F_Mask.gts, geodude-carrier-F_Silkscreen.gto, geodude-carrier-job.gbrjob]
2026-03-30 4-pin fan header + tach jumper, 271 tracks, 1 unconnected PWM, Gerbers ready
    [geodude-carrier-B_Cu.gbl, geodude-carrier-B_Mask.gbs, geodude-carrier-B_Silkscreen.gbo, geodude-carrier-Edge_Cuts.gm1, geodude-carrier-F_Cu.gtl, geodude-carrier-F_Mask.gts, geodude-carrier-F_Silkscreen.gto, geodude-carrier-job.gbrjob]
2026-03-30 2x4 fan header (tach+PWM mirrored), rounded corners 3mm, 273 tracks, 0 unconnected, Gerbers ready
    [geodude-carrier-B_Cu.gbl, geodude-carrier-B_Mask.gbs, geodude-carrier-B_Silkscreen.gbo, geodude-carrier-Edge_Cuts.gm1, geodude-carrier-F_Cu.gtl, geodude-carrier-F_Mask.gts, geodude-carrier-F_Silkscreen.gto, geodude-carrier-job.gbrjob]
2026-03-30 Rounded corners 5mm, re-routed 282 tracks, 0 unconnected, Gerbers
    [geodude-carrier-B_Cu.gbl, geodude-carrier-B_Mask.gbs, geodude-carrier-B_Silkscreen.gbo, geodude-carrier-Edge_Cuts.gm1, geodude-carrier-F_Cu.gtl, geodude-carrier-F_Mask.gts, geodude-carrier-F_Silkscreen.gto, geodude-carrier-job.gbrjob]
2026-03-30 Wider board 128x149mm, 6mm rounded corners, fuses spread, 273 tracks, 0 unconnected
    [geodude-carrier-B_Cu.gbl, geodude-carrier-B_Mask.gbs, geodude-carrier-B_Silkscreen.gbo, geodude-carrier-Edge_Cuts.gm1, geodude-carrier-F_Cu.gtl, geodude-carrier-F_Mask.gts, geodude-carrier-F_Silkscreen.gto, geodude-carrier-job.gbrjob]
2026-03-30 Spacing and boundary fix
    [geodude-carrier.kicad_pcb]
2026-03-30 Fixed board outline (was cutting into components), 140x149mm 6mm corners, 289 tracks, 0 unconnected, 1 thermal warning
    [geodude-carrier-B_Cu.gbl, geodude-carrier-B_Mask.gbs, geodude-carrier-B_Silkscreen.gbo, geodude-carrier-Edge_Cuts.gm1, geodude-carrier-F_Cu.gtl, geodude-carrier-F_Mask.gts, geodude-carrier-F_Silkscreen.gto, geodude-carrier-job.gbrjob]
2026-03-30 Alignment fixed (MH 50mm, servos snapped), 253 tracks, 1 unconnected PWM, Gerbers
    [geodude-carrier-B_Cu.gbl, geodude-carrier-B_Mask.gbs, geodude-carrier-B_Silkscreen.gbo, geodude-carrier-Edge_Cuts.gm1, geodude-carrier-F_Cu.gtl, geodude-carrier-F_Mask.gts, geodude-carrier-F_Silkscreen.gto, geodude-carrier-job.gbrjob]
2026-03-30 Border adjustment
    [geodude-carrier.kicad_pcb]
2026-03-30 Re-routed with adjusted edges, 253 tracks, 1 unconnected
    [geodude-carrier-B_Cu.gbl, geodude-carrier-B_Mask.gbs, geodude-carrier-B_Silkscreen.gbo, geodude-carrier-Edge_Cuts.gm1, geodude-carrier-F_Cu.gtl, geodude-carrier-F_Mask.gts, geodude-carrier-F_Silkscreen.gto, geodude-carrier-job.gbrjob]
2026-03-30 Added back silkscreen quote, Gerbers updated
    [geodude-carrier-B_Cu.gbl, geodude-carrier-B_Mask.gbs, geodude-carrier-B_Silkscreen.gbo, geodude-carrier-Edge_Cuts.gm1, geodude-carrier-F_Cu.gtl, geodude-carrier-F_Mask.gts, geodude-carrier-F_Silkscreen.gto, geodude-carrier-job.gbrjob]
2026-03-30 Edge adjustment
    [geodude-carrier.kicad_pcb]
2026-03-30 Tighter board 140x136mm 6mm corners, 289 tracks, 0 unconnected, 0 electrical violations
    [geodude-carrier-B_Cu.gbl, geodude-carrier-B_Mask.gbs, geodude-carrier-B_Silkscreen.gbo, geodude-carrier-Edge_Cuts.gm1, geodude-carrier-F_Cu.gtl, geodude-carrier-F_Mask.gts, geodude-carrier-F_Silkscreen.gto, geodude-carrier-job.gbrjob]
2026-03-31 Board 140x134mm, fan +12V thin trace, render, 1 unconnected PWM, Gerbers ready
    [geodude-carrier-B_Cu.gbl, geodude-carrier-B_Mask.gbs, geodude-carrier-B_Silkscreen.gbo, geodude-carrier-Edge_Cuts.gm1, geodude-carrier-F_Cu.gtl, geodude-carrier-F_Mask.gts, geodude-carrier-F_Silkscreen.gto, geodude-carrier-job.gbrjob]
2026-03-31 Single servo row, ESC/Fan above, 140x134mm, render, Gerbers
    [geodude-carrier-B_Cu.gbl, geodude-carrier-B_Mask.gbs, geodude-carrier-B_Silkscreen.gbo, geodude-carrier-Edge_Cuts.gm1, geodude-carrier-F_Cu.gtl, geodude-carrier-F_Mask.gts, geodude-carrier-F_Silkscreen.gto, geodude-carrier-job.gbrjob]
2026-03-31 Fully routed 242 tracks, 0 unconnected, 1 silk warning, Gerbers ready
    [geodude-carrier-B_Cu.gbl, geodude-carrier-B_Mask.gbs, geodude-carrier-B_Silkscreen.gbo, geodude-carrier-Edge_Cuts.gm1, geodude-carrier-F_Cu.gtl, geodude-carrier-F_Mask.gts, geodude-carrier-F_Silkscreen.gto, geodude-carrier-job.gbrjob]
2026-03-31 Add SimpleFOC system: Pi Pico, FOC driver, motor UVW, IMU, encoder, serial link. Remove ESC.
    [geodude-carrier.kicad_pcb]
2026-03-31 Proper Pico THT footprint, FOC components moved to left side
    [geodude-carrier.kicad_pcb]
2026-03-31 Carrier PCB docs: SimpleFOC system, Pi Pico, IMU breakout, remove ESC
2026-03-31 170mm wide layout, FOC components left, mounting holes removed, unrouted
    [geodude-carrier.kicad_pcb]
2026-03-31 Manual layout update
    [geodude-carrier.kicad_pcb]
2026-03-31 Pinouts fixed, 3x19 PCA, routed but needs placement work (488 DRC)
    [geodude-carrier-B_Cu.gbl, geodude-carrier-B_Mask.gbs, geodude-carrier-B_Silkscreen.gbo, geodude-carrier-Edge_Cuts.gm1, geodude-carrier-F_Cu.gtl, geodude-carrier-F_Mask.gts, geodude-carrier-F_Silkscreen.gto, geodude-carrier-job.gbrjob]
2026-03-31 Stripped for placement work
    [geodude-carrier.kicad_pcb]
2026-03-31 Add ESP32 gimbal firmware (TMC2209 stepper control)
    Arduino sketch from Mac ~/tmp/tmc2209_read/. Web UI for TMC2209
    driver scanning, motor stepping, current setting, and OTA updates.
    Pin assignments may need updating after hardware verification.
2026-03-31 Bidirectional ESC support for MACE reaction wheel
    - Add BIDIRECTIONAL_ESC flag (True for new ESC, False for old Drfeify)
    - Remap PID output to center-stick: 1500us=stop, ±400us range
    - Bidirectional pid_to_motor() maps [-100,100] with deadband skip
    - Signed RPM (removed abs()), reduced averaging window 50→10 samples
    - Remove 3s arming sequence for bidirectional ESC
    - Update all stop/coast/watchdog paths for 1500us center
    - sensor_server: signed RPM, updated /motor endpoint
    [sensor_server.py]
2026-03-31 Fix Driver 2 pin assignment: swap STEP/DIR (GPIO 22/23)
    Driver 2 (Roll) was {23, 22} (step, dir), corrected to {22, 23}.
    Verified and flashed OTA to ESP32.
2026-03-31 Set IHOLD=0 on TMC2209 drivers to prevent idle heating
    Motors were overheating when powered with no stepping — drivers
    hold current at IRUN level by default. IHOLD=0 means zero current
    when not stepping, motors free-spin at idle.
2026-03-31 Fix IHOLD=0: move begin() out of doScan() to prevent reset
    doScan() was calling begin() on all drivers, which reinitialized
    them and overwrote the IHOLD=0 register write. Split into
    initDrivers() (called once at boot) and doScan() (read-only).
2026-03-31 Use toff(0) to disable drivers at idle instead of IHOLD=0
    StealthChop pwm_autoscale overrides IHOLD register — the chip's
    automatic current scaling maintains holding current even with
    IHOLD=0. toff(0) disables the output stage entirely for true zero
    idle current. toff(4) re-enables before stepping.
2026-03-31 Add acceleration ramp + switch to SpreadCycle
    - Ramp from 8000us to target step delay, accelerating 50us per step
    - Prevents missed steps from instant full-speed start
    - Switch from StealthChop to SpreadCycle for more reliable stepping
2026-03-31 Disable all drivers at boot with toff(0)
    Previously drivers used TMC2209 factory defaults on power-up
    (non-zero IHOLD), causing motors to heat until Setup was clicked.
    Now initDrivers() sets toff(0) immediately after begin() so
    drivers output zero current from the moment they're initialized.
2026-03-31 Add deceleration ramp for smooth motor stopping
    Trapezoidal velocity profile: accelerate from 8000us to target
    step delay, cruise, then decelerate symmetrically. Prevents
    abrupt stops that caused motor oscillation on longer moves.
2026-03-31 Add custom step count input to motor control UI
2026-03-31 Update docs: bidirectional ESC, Driver 2 pin fix, carrier PCB updates
    - GEO-DUDe: new bidirectional 40A ESC specs, center-stick control
    - Gimbal: fix Driver 2 STEP/DIR pin order (GPIO 22/23)
    - Basestation: update MACE panel docs for bidirectional ESC
    - Carrier PCB: SimpleFOC section, fuse holder pitch update
2026-03-31 Unified control UI: gimbal panel + ESP32 JSON API
    ESP32 firmware stripped to pure JSON API — no HTML. Endpoints:
    /status, /scan, /setup, /move, /stop, /stop_all, /speed, /current.
    CORS headers for cross-origin access.
    wheel_control.py gains gimbal panel with:
    - Driver status polling (1Hz)
    - Setup/Scan/Stop All buttons
    - Speed and current sliders
    - Per-motor step buttons (±200, ±1000, custom) and stop
    - Proxies to ESP32 at 192.168.4.222
2026-03-31 Revamp UI: tabbed layout, compact header, full gimbal parity
    - Tabbed navigation: GEO-DUDe / Gimbal / Servos
    - Always-visible header: camera (400px), system stats, sensor strip
    - Dual connection status dots (GEO-DUDe + Gimbal)
    - Wider layout (1200px max)
    - Gimbal tab: speed presets, current input, per-driver detail
    cards with OT/OTPW warnings, collapsible driver info,
    ±5000 step buttons
    - ESP32 firmware: pure JSON API, no HTML
2026-03-31 Fix JS syntax errors: quote escaping for Jinja2 render
    render_template_string strips backslash escapes. Use &quot; for
    quotes inside HTML attribute strings (onclick, oninput handlers).
    Also fix switchTab to pass button element directly.
    [wheel_control.py]
2026-03-31 Compact layout: full width, tighter spacing throughout
    [wheel_control.py]
2026-03-31 More compact: tighter padding, margins, gaps, font sizes
    [wheel_control.py]
2026-03-31 Carrier PCB v2: SimpleFOC, custom footprints, copper pours, routed
    Complete redesign with SimpleFOC motor control replacing ESC.
    Custom footprints from EasyEDA/Eagle source files:
    - SimpleFOC Mini v1.0 (from EasyEDA design)
    - SparkFun ICM-20948 IMU (from Eagle board file)
    - PCA9685 Adafruit breakout
    - AS5600 encoder (1x4 I2C header)
    Layout: 150x118mm, 1oz copper, rounded corners, 4x M3 mounting holes.
    Power pours: +12V, +7V4, +5V_SERVO, GND, GND_LOGIC on F.Cu.
    Autorouted with Freerouting, JLCPCB design rules verified.
    [geodude-carrier-B_Cu.gbl, geodude-carrier-B_Mask.gbs, geodude-carrier-B_Paste.gbp, geodude-carrier-Edge_Cuts.gm1, geodude-carrier-F_Cu.gtl, geodude-carrier-F_Mask.gts, geodude-carrier-F_Paste.gtp, geodude-carrier-F_Silkscreen.gto]
2026-03-31 Major gimbal upgrade: per-motor config, angle control, S-curve, sequences
    ESP32 firmware:
    - Per-motor current (run + idle), enable/disable, gear ratios
    - Angle-based moves (/move_deg) with gear reduction conversion
    Yaw 2:1, Pitch 3.25:1, Roll 1:1 direct, Belt steps only
    - S-curve velocity profile with configurable jerk (0=linear, 10=full)
    - Emergency stop (/estop)
    - Move requires motor enabled, setup done
    - New proxy routes: move_deg, enable, disable, motor_current,
    motor_ihold, jerk, estop, sequence
    - Sequence executor: timed movement entries run in background thread
    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
2026-03-31 Split UI into separate files + full gimbal control rewrite
    Structure:
    - wheel_control.py: Flask backend only (590 lines, was 2000+)
    - templates/index.html: HTML structure
    - static/style.css: all styles
    - static/app.js: all JavaScript
    New gimbal UI features:
    - Per-motor enable/disable toggles
    - Per-motor run current + idle current sliders
    - Angle control for Yaw/Pitch/Roll (gear ratio conversion)
    - Step control for Belt
    - Quick-move buttons (+/-1,5,10,45,90 degrees)
    - Client-side position tracking
    - S-curve jerk control slider (0-10)
    - Emergency stop button
    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
2026-03-31 Add camera snapshot button — exports current frame as JPG
2026-03-31 Fix idle heating: force SpreadCycle + toff(0) at boot before any autoscale
2026-03-31 Auto-disable drivers on 24V power-on: 500ms watchdog detects driver appearance
2026-03-31 Remove Setup requirement: Enable configures driver fully, no setupDone gate
2026-03-31 Fix step jitter: skip WiFi handling during active stepping
2026-03-31 Update fuse holder footprint pitch and simplify generate_pcb.py
2026-03-31 Reorganize repo by device/purpose
    groundstation/ — wheel_control.py + templates + static (runs on groundstation Pi)
    geodude/ — sensor_server.py, attitude_controller.py (runs on GEO-DUDe Pi)
    gimbal/ — gimbal_controller.ino (runs on ESP32, renamed from tmc2209_read.ino)
    pcb/ — KiCad carrier PCB design
    docs/ — documentation site (flattened from docs/docs/)
    .github/ — CI workflows
    zensical.toml — docs site config (moved to root)
2026-03-31 Move docs into site/, add CLAUDE.md, remove AGENT_ONBOARDING from site
    site/ — Zensical docs site (zensical.toml + docs/)
    CLAUDE.md — project instructions, deploy paths, known issues
    AGENT_ONBOARDING.md — stays at root for developer reference
2026-03-31 Add PCB agent onboarding docs (pcb/CLAUDE.md)
2026-03-31 Note two Pico pin versions (perfboard vs PCB), update PCB pins to match routed layout
2026-03-31 Comprehensive PCB workflow docs: design flow, SWIG gotchas, iteration checklist
2026-04-01 Add servo neutral positions and configurable ramp speed
    - Per-servo neutral positions saved to localStorage
    - Set Neutral button saves current slider position
    - Neutral / All Neutral buttons ramp servos to saved neutral
    - Ramp speed slider controls how fast servos move to target
2026-04-01 Rate-limit servo slider movements with max velocity
    Slider drags no longer send PWM directly. A continuous ramp
    loop (30Hz) moves actual PWM toward the slider target at the
    configured max speed. Prevents jerky servo movements when
    dragging sliders quickly. Center and Neutral buttons also go
    through the same rate-limited path.
2026-04-01 Add separate ramp rate slider for center/neutral buttons
    Two speed controls:
    - Max Slider Speed: caps PWM change rate when dragging sliders
    - Button Ramp Rate: controls center/neutral button movement speed
2026-04-01 Track servo positions server-side, no snap on page reload
    Server remembers last PWM sent to each servo channel. On page
    load, JS fetches positions and sets sliders to match without
    sending any PWM commands. Prevents dangerous servo snap to
    center on reload.
    [wheel_control.py]
2026-04-01 Unify servo speed into single global slider
    One Servo Speed slider controls all servo movement - slider
    drags, center button, neutral button all rate-limited the same.
2026-04-01 Add ramp rate slider, persist speed settings, fix camera multi-client
    - Ramp rate slider back (controls center/neutral button speed)
    - Servo speed + ramp rate persist in localStorage across reloads
    - Camera: single reader thread fans out frames to all clients,
    fixes stream corruption when multiple browsers connect
    [sensor_server.py]
2026-04-01 Trapezoidal velocity profile for servo movement
    Ramp rate now controls acceleration/deceleration, not target speed.
    Servos smoothly ramp up to max servo speed, then decelerate as they
    approach the target position. Both slider drags and button presses
    go through the same velocity profile.
2026-04-01 Revert camera fan-out, single client only
    [sensor_server.py]
2026-04-01 Add slow/fast and gentle/snappy labels to servo sliders
2026-04-01 Make Set Neutral button red
2026-04-01 Store servo neutral positions server-side on disk
    Neutral positions saved to servo_neutral.json on the groundstation
    Pi. Survives page reloads, browser changes, and reboots.
    [wheel_control.py]
2026-04-01 Camera fan-out for multi-client support
    Single reader thread captures frames from rpicam-vid, stores
    latest frame in shared buffer. Each client generator waits on
    a condition variable and gets a copy. No more stream corruption
    when multiple browsers connect.
2026-04-01 Sync servo sliders across multiple clients
    Poll server positions every 500ms. If another client moved a
    servo and this client isn't actively dragging or ramping, update
    the slider to match. Both browsers stay visually in sync.
2026-04-01 Rename Neutral button to Go to Neutral
2026-04-01 Order servos as Arm 1 (left) and Arm 2 (right) columns
2026-04-01 Persist servo positions to disk, fixes dangerous snap on reboot
    servo_positions.json written on every PWM change. On service
    restart, positions are loaded so chActual initializes correctly.
    Prevents servos jumping to 1500 when Go to Neutral is pressed
    after a reboot.
    [wheel_control.py]
2026-04-01 Add STARTUP button: sends neutral PWM directly, no ramp
2026-04-01 Auto-restore servo positions on boot
    On startup, waits for GEO-DUDe to come online (up to 2 min),
    then sends all last-known servo positions. Servos resume where
    they were before reboot without manual intervention.
    [wheel_control.py]
2026-04-01 Safe servo startup: neutral on boot, remove dangerous center
    - sensor_server: remove pca_all_off() on boot, let groundstation
    send neutral positions instead of leaving servos limp
    - Restore loop sends neutral positions, not last-known
    - chActual defaults to neutral, not 1500
    - Remove ALL CENTER button and per-servo Center button (1500us
    fully extends arms, dangerous)
    - STARTUP button remains for manual neutral initialization
2026-04-01 Remove S-curve/jerk, fix gimbal stutter during long moves
    - Remove smoothstep, computeDelay, jerkLevel, totalSteps
    - Stepping now uses flat stepDelay (constant speed)
    - Skip TMC UART reads in /status while motors are stepping,
    eliminates 50-100ms pauses from driver register reads
    - Remove jerk slider, endpoint, and proxy from UI and server
    [gimbal_controller.ino, wheel_control.py]
2026-04-01 Update CLAUDE.md with servo safety, startup flow, gimbal, deploy docs
2026-04-01 Update CLAUDE.md: repo on Pi at /opt, users, bundle deploy flow
2026-04-02 Refactor MACE reaction wheel control from ESC/PCA9685 to SimpleFOC/Pico USB serial
    - geodude/sensor_server.py: add /simplefoc endpoint that sends velocity commands
    to Pi Pico over USB serial (/dev/ttyACM0, 115200 baud) using SimpleFOC Commander
    protocol (T<value>\n). Legacy /motor endpoint kept, translates ESC PWM to velocity.
    - groundstation/wheel_control.py: replace ESC PWM logic with velocity (rad/s) control.
    send_motor() -> send_velocity(), /api/throttle -> /api/velocity, /api/arm now
    instantly enables/disables (no 3s ESC arm sequence), /api/calibrate removed,
    state tracks velocity instead of throttle/reverse/armed/arming.
    - groundstation/templates/index.html: replace throttl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
    [sensor_server.py, wheel_control.py]
2026-04-02 Revamp MACE reaction wheel UI for SimpleFOC velocity control
    - Replace old throttle bar with clean bidirectional velocity bar
    (center=0, left=negative, right=positive, -20..+20 rad/s range)
    - Add center tick mark and scale labels (-20, -10, 0, +10, +20)
    - Side-by-side slider layout for target velocity and ramp rate
    - Default ramp rate changed from 1.0 to 5.0 rad/s/s
    - Preset buttons already call sendVelocity directly (confirmed working)
    - SET VELOCITY starts disabled; requires ENABLE first
    - Add Pico USB connection status row to MACE Status card
    - Remove leftover isHolding variable and btn-hold CSS from ESC era
    - Clean up spacing: slider-scale helper class, mace-presets spacing
2026-04-02 Add MACE SimpleFOC/Pico section to CLAUDE.md
2026-04-02 MACE: clean rewrite for SimpleFOC / Pi Pico system
    Remove all ESC/PCA9685/ramp legacy code from the reaction wheel stack.
    MACE is now purely SimpleFOC over USB serial at /dev/ttyACM0.
    sensor_server.py:
    - Remove MACE from CHANNELS dict (no longer on PCA9685)
    - Remove legacy /motor endpoint (ESC PWM translation)
    - Add GET /simplefoc/status endpoint (sends T\n, returns connection + target)
    wheel_control.py:
    - Replace old state dict with clean mace{} state dict (enabled, target,
    velocity, connected, error)
    - Remove ramp_loop and all ramp rate logic (SimpleFOC handles acceleration)
    - Remove /api/arm, /api/velocity, /api/brake, /api/stop, /api/config,
    /api/simplefoc proxy
    - Add /api/mace/ena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
    [sensor_server.py, wheel_control.py]
2026-04-03 Pico SimpleFOC firmware: streaming telemetry, I2C1 sensors, loopFOC fix
    [pico-simplefoc.ino]
2026-04-04 Pico firmware: closed-loop velocity, driver limit 12V, tuning commands, DRV8313 control pins
2026-04-04 Pico firmware: PID limit sync, driver voltage 12V, tuning params in stream, DRV8313 reset/sleep/fault pins
    [pico-simplefoc.ino]
2026-04-04 Pico firmware: analog encoder (AS5600 OUT->GP26), PID limit sync, higher speed capability
2026-04-04 Update CLAUDE.md: full MACE SimpleFOC docs, analog encoder, hardware notes, telemetry format
2026-04-07 Transition MACE from Pi Pico to STM32 Nucleo F446RE + SimpleFOC Shield V2
    - Add Nucleo firmware (nucleo/nucleo-simplefoc.ino) for STM32F446RE
    - SimpleFOC Shield V2.0.4 (IR2104 drivers, INA240 current sensing)
    - MT6701 encoder in ABZ mode (1024 PPR, hardware encoder timer)
    - ICM20948 IMU on I2C (0x69)
    - Torque mode (M1) and velocity mode (M0) support
    - Motor disabled on boot, initFOC skippable
    - 50Hz JSON telemetry stream over ST-LINK virtual COM
    - Update CLAUDE.md with Nucleo hardware, pin mapping, new architecture
    - Add mace-development-log.md documenting full Pico development history
    - All 14 issues encountered and solutions
    - Performance measurements, lessons learned
    - Pic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
    [nucleo-simplefoc.ino, pico-simplefoc.ino]
2026-04-07 Add cascaded attitude control, updated GUI with plots and MACE section toggle
    - Rewrite attitude_controller.py: single PID (angle -> voltage), torque mode
    - Auto gyro calibration on enable, proper enable/disable chain
    - Switches Pico/Nucleo to torque mode (M1) on enable, disables motor on disable
    - Anti-windup, D term on measurement, voltage deadband for cogging
    - GUI: attitude control above MACE in control authority
    - Attitude plot (commanded vs body angle vs error)
    - Wheel speed/voltage plot
    - MACE section disableable (auto-disabled when attitude active)
    - Number input fields for PID tuning (no sliders)
    - Speed chart for MACE manual control
    - Backend: mutual exclusion betwe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
    [wheel_control.py]
2026-04-07 Add Nucleo F446RE firmware, attitude controller, and development log
    - nucleo/nucleo-simplefoc.ino: SimpleFOC for STM32F446RE + Shield V2.0.4
    - MT6701 encoder (ABZ, 1024 PPR), ICM20948 IMU (I2C)
    - Velocity and torque modes, motor disabled on boot
    - 50Hz JSON telemetry, full serial command set
    - geodude/attitude_controller.py: single PID (angle -> voltage)
    - Auto gyro calibration, torque mode switching, motor safety
    - Mutual exclusion with MACE manual controls
    - site/docs/electrical/geodude/mace-development-log.md
    - Full Pico-era development history, 14 issues documented
    - CLAUDE.md: updated for Nucleo hardware, retired Pico docs
    [nucleo-simplefoc.ino]
2026-04-07 Nucleo firmware: IMU + encoder working, sensor_server rewritten for Nucleo
    - nucleo-simplefoc.ino: no SimpleFOC dependency (was hanging)
    - ICM20948 IMU on I2C (400kHz), live accel + gyro
    - MT6701 encoder ABZ on D2/D3 with interrupts
    - Full JSON telemetry at 50Hz matching sensor_server fields
    - Motor init deferred (send G when ready)
    - sensor_server.py: rewritten, all pico references removed
    - Nucleo serial on /dev/ttyACM0 via ST-LINK virtual COM
    - DTR/RTS disabled to avoid resetting Nucleo on port open
    - Auto-reconnect on serial timeout (5s)
    - PCA9685 init made optional (may not be connected)
    [nucleo-simplefoc.ino, sensor_server.py]
2026-04-07 Nucleo firmware: SimpleFOC driver init working, torque mode, deferred initFOC
2026-04-08 Keep sensor server alive if PCA init fails
    [sensor_server.py]
2026-04-21 Make IMU optional in sensor loop
2026-04-21 Make wheel calibration explicit
2026-04-21 Fix reaction wheel hold button races
2026-04-21 Reduce wheel jog latency and show wheel RPM
2026-04-21 Reaction wheel: fix jog race, cut hot-path lock time, decouple calibrate
    - GEO-DUDe: cmd_seq pre-empt so a release arriving mid-start coasts
    instead of letting T+E arm after release.
    - GEO-DUDe: cache pushed MR/V/R; hot path drops from ~320ms lock hold
    (6 commands) to ~50ms (T+E). Cache invalidated on serial re-open and
    on calibrate.
    - GEO-DUDe: jog/start uses cached foc_ready instead of a pre-flight
    serial round-trip.
    - GEO-DUDe: heartbeat route no longer touches serial port.
    - GEO-DUDe: dedicated /simplefoc/calibrate + /calibrate/state routes,
    decoupled from profile/tuning state machine. jog/start gates on
    calibrate busy, not profile busy.
    - Groundstation: delete mace_jog_watch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
    [sensor_server.py, wheel_control.py]
2026-04-21 Reaction wheel: fix wheel RPM source + add structured [rw] logs
    - Browser: /api/sensors poll was overwriting maceJogRpm with the Pi
    I2C body encoder RPM every tick, clobbering the wheel RPM that
    /api/mace/jog/status had just set. Wheel RPM is a different sensor
    (Nucleo encoder via SimpleFOC) and belongs only to the jog status
    path. Stop writing it from the sensors poll and drop the misleading
    body_rpm fallback in maceRenderStatus (show '—' if unknown).
    - GEO-DUDe: add _rw_log helper emitting '[rw] <event> k=v ...' lines on
    hold_start, coast, preempt, watchdog_trip, watchdog_err,
    calibrate_start, calibrate_done. Each hot-path event includes an
    elapsed_ms so 'laggy press' sy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
    [sensor_server.py]
2026-04-21 Reaction wheel: fire-and-forget on jog hot path
    Press/release latency was dominated by serial read_for waits for replies
    the firmware never sends while armed. Switch T/E on start, D on release,
    and the MR/V/R config push to fire-and-forget writes (write+flush, no
    read loop). Caller still holds pico_lock during the write, so no serial
    races; any status lines the firmware does emit get picked up by the next
    actual read (status poll, calibrate).
    Expected pico_lock hold time per press:
    - Previously: ~70ms (T 20ms + E 50ms) for repeat press, +90ms on first
    press from the MR/V/R push.
    - Now: ~2-5ms USB write time regardless of first-vs-repeat.
    Trade-off: we no longer catch firmware ERR replies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
    [sensor_server.py]
2026-04-21 Reaction wheel: background status poller so wheel_rpm stays live
    Firmware only prints status on events (press/release/calibrate), so the
    cached enc_rpm was frozen between events and the UI's Wheel RPM field
    showed stale/zero while spinning. Add a background thread that issues S
    at 500ms while active (3.4% firmware time blocked on Serial.print) and
    2s while idle. Uses pico_lock with a short read_for so user commands
    win any race.
    [sensor_server.py]
2026-04-21 Nucleo firmware: switch to SpaceVectorPWM for +15% peak Uq
    SinePWM centered on a 24V bus caps Uq at Vbus/2 = 12V, which was the
    real ceiling on reaction wheel torque regardless of the max_voltage
    slider. SpaceVectorPWM raises the max to Vbus/sqrt(3) ~= 13.86V — 15%
    more peak Uq, therefore ~15% more peak current and torque through
    I_max ~= Uq/R_phase. No smoothness/ripple downside vs SinePWM.
    Flash: st-flash write /tmp/nucleo.bin 0x08000000 && st-flash reset
    (run on GEO-DUDe Pi; binary pre-staged at /tmp/nucleo.bin).
    [nucleo-simplefoc.ino]
2026-04-21 Reaction wheel: raise ramp cap + fix brake-pulse on re-press while coasting
    Symptom 1: low torque off the line. The velocity-setpoint ramp (capped
    at 50 rad/s^2 in 4 places) means the target itself climbs from 0 toward
    run_target, so the velocity PID sees near-zero error near t=0 and
    commands near-zero Uq. Fix: raise cap to 2000 rad/s^2 everywhere
    (firmware R clamp, MACE_JOG_MAX_RAMP on GS + GEO-DUDe, UI slider max).
    At 2000 the target reaches 500 RPM in ~30ms, i.e. effectively a step,
    and the PID saturates Uq immediately — peak torque from t=0.
    Symptom 2: re-pressing the same direction while the wheel is still
    coasting from a previous release briefly brakes the wheel before
    accelerating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
    [nucleo-simplefoc.ino, sensor_server.py, wheel_control.py]
2026-04-21 rw: reseed LPF_velocity on re-enable to kill brake pulse on fast re-press
    The earlier bumpless-resume fix seeded current_target from encoder velocity
    but left motor.LPF_velocity.y_prev frozen at the pre-release steady-state
    speed. On fast re-press (<300ms so LPF's own stale-reset didn't fire), the
    PID measurement read ~prev_speed for ~5*Tf (400ms), producing a brake
    pulse toward current_target. Latch the filter to the current shaft-frame
    velocity by running it once with Tf=0.
    [nucleo-simplefoc.ino]
2026-04-21 Fix gimbal idle current handling
    [gimbal_controller.ino]
2026-04-21 Raise belt ramp slider max
2026-04-21 servo: default envelope to full 500..2500, not neutral +/- 600
    Neutrals on this robot are joint-extended positions, not mechanical
    centers, so neutral +/- 600 silently chopped half the travel on every
    channel where the neutral wasn't ~1500. That's not safety, it's a bug.
    Default to the full pulse window. servo_limits.json still exists as an
    opt-in tightening mechanism once real mechanical stops are measured
    per joint. Slew-rate clamp (SERVO_MAX_DELTA_US) continues to catch bad
    single commands.
    Also drop the auto-reload of servo_limits after /api/servo_neutral POST:
    defaults no longer depend on neutrals, so it was just dead weight.
    [wheel_control.py]
2026-04-21 Add gimbal multi-step filter toggle
2026-04-22 servo: restore saved positions on boot + flag HW:0 as ERROR
    Bootstrap seed now uses servo_positions.json (last-known position)
    instead of always seeding to neutral, and retries every 2s until
    GEO-DUDe answers. Handles either-boot-first ordering without leaving
    servos unpowered. Also syncs the ramp state to match seeded pw so
    the first user command doesn't staircase.
    UI: HW:0 now renders as 'HW: 0 us ERROR' in red, since 0us output
    means the servo is unpowered -- almost always a failed boot restore.
    [wheel_control.py]
2026-04-22 servo: fetch neutrals from server on page load, atomic save
    CRITICAL safety bug: chNeutral was hardcoded in app.js with values
    that became stale the moment the operator re-measured neutrals in
    the UI. Set Neutral correctly persisted to servo_neutral.json, but
    a page refresh/reboot reloaded the JS with the OLD hardcoded values.
    A subsequent Go to Neutral / STARTUP then drove arms to the OLD
    positions, potentially into cables or mechanical stops.
    Now:
    - chNeutral starts empty, hydrated from GET /api/servo_neutral on
    page load.
    - getNeutral() returns null when neutrals aren't loaded yet.
    - chGoNeutral/startupNeutral refuse to move and alert the operator
    if neutrals haven't loaded (server u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
    [wheel_control.py]
2026-04-22 Make gimbal go-zero use shortest path
    [gimbal_controller.ino]
2026-04-22 servo: PW<->angle calibration + arm viz fix
    Adds per-joint linear calibration (us_per_rad, sign, neutral_angle_rad,
    min/max_angle_rad) stored in groundstation/joint_calibration.json.
    - angle_rad = neutral_angle_rad + (pw - neutral_pw)/us_per_rad * sign
    - servo_neutral.json keeps the rest PW; this file is a separate concern
    (what does motion mean).
    - Defaults: 270deg servos over 500..2500us => ~424 us/rad. neutral_angle
    defaults to 0 for base/wrists, pi/2 for shoulder/elbow.
    - GET/POST /api/joint_calibration for full read / per-channel patch.
    - POST /api/joint_calibration/solve takes two (pw, angle) samples and
    computes us_per_rad, sign, neutral_angle_rad.
    - /api/ik/status (previously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
    [wheel_control.py]
2026-04-22 calib: collapse calibration panel into compact per-joint cards
    13-column table was visually overwhelming. New layout is a
    responsive grid of collapsed cards (one per channel). Each card
    shows name, live reading, and one-line summary (us/rad · sign ·
    neutral°). Click to expand into A/B capture + Solve controls and
    min/max limit inputs.
2026-04-22 Show signed yaw and pitch angles
